FedeAdra25/despertadorInteligente/README.md

# Despetador Inteligente con STM32F103C8

### En este trabajo práctico desarrollaremos un sistema que todos hemos utilizado en algún momento, Se trata de un reloj despertador. Claramente, no se trata simplemente de un reloj despertador (ya que el sistema sería demasiado sencillo), sino que a su vez, cuenta con un display gráfico donde se muestra la hora, la fecha, la temperatura y la humedad actual. Además de todo esto, cuenta con la posibilidad de establecer una alarma a la hora deseada por el usuario.

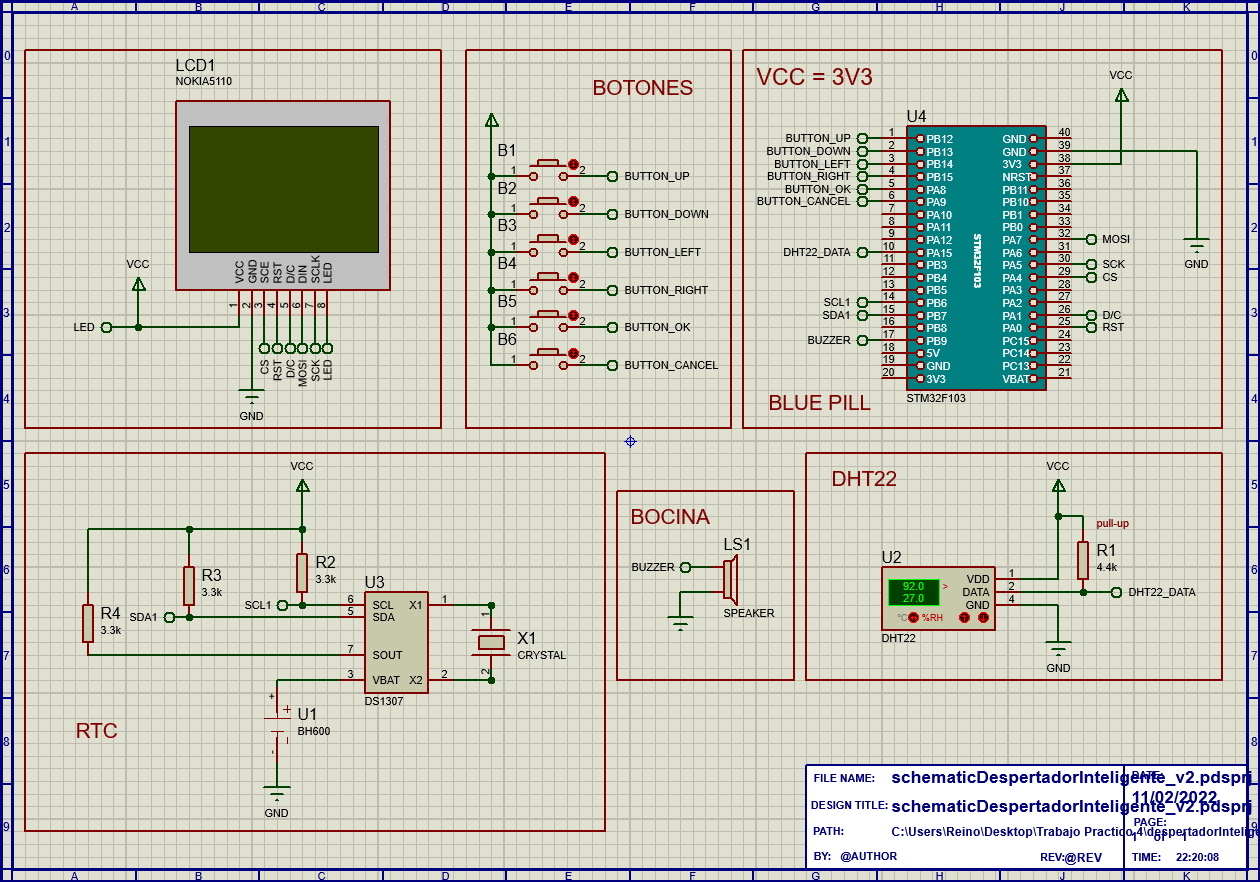
[picture p1: img/schematic.jpg]
Schematic

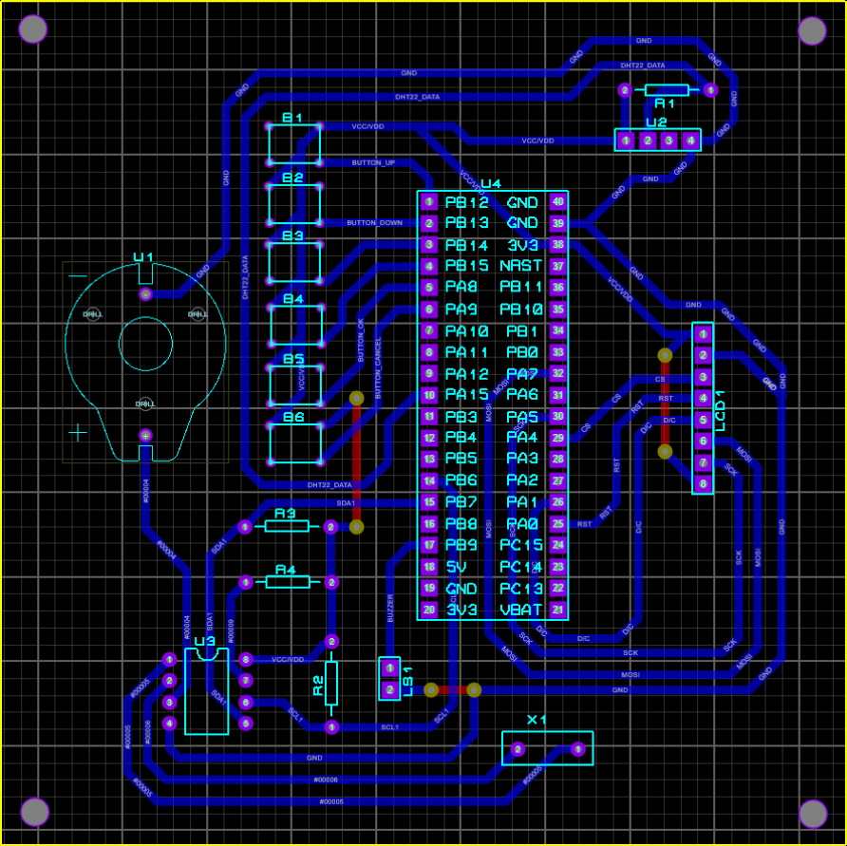
[picture p2: img/PCB_V2.jpg]
PCB

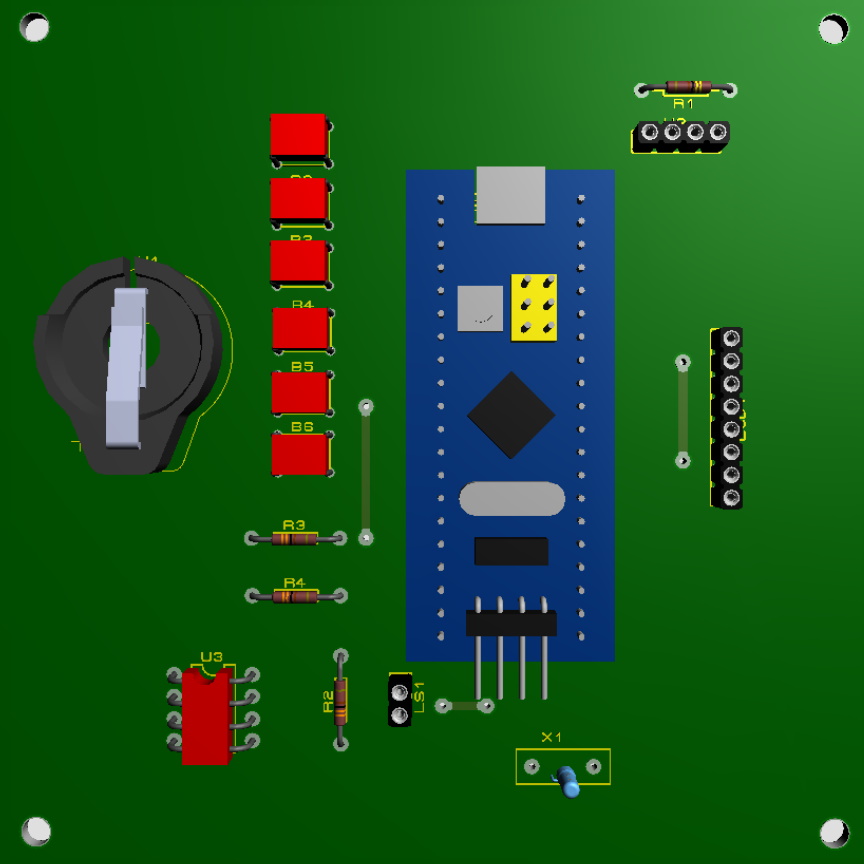
[picture p3: img/3D_MODEL.jpg]
3D Model
