FedeAdra25/despertadorInteligente/Archivos de uso Temporal/Auxiliares/README.md

python .\n5110_BMP_converter.py filename.bmp

el Archivo Filename.bmp debe ser creado en paint obligatoriamente
(Se intento usar Paint.net, descargar archivos .bmp o usar conversores online,
pero ninguno de estos funciona).

Luego de la conversion se genera un archivo .txt el cual contiene los datos
necesarios para utilizar la imagen en el STM32F1
