FedeAdra25/despertadorInteligente/Archivos de uso Temporal/MEF.drawio.png

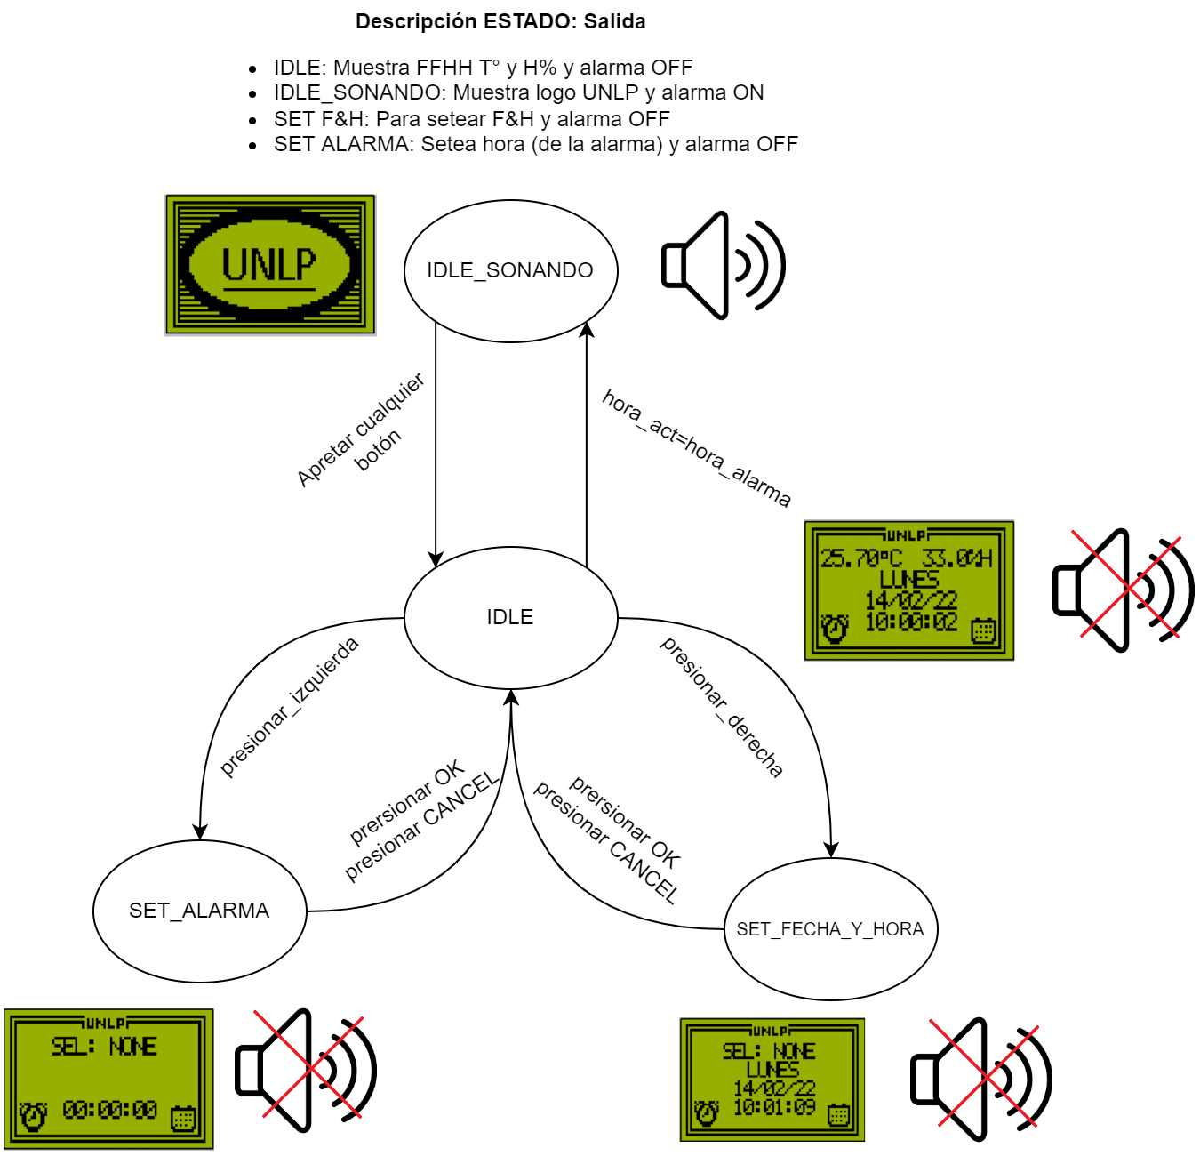
Archivos de uso Temporal/MEF.drawio.png
