FedeAdra25/despertadorInteligente/img/PCB_CUSTOM_CRYSTAL.jpg

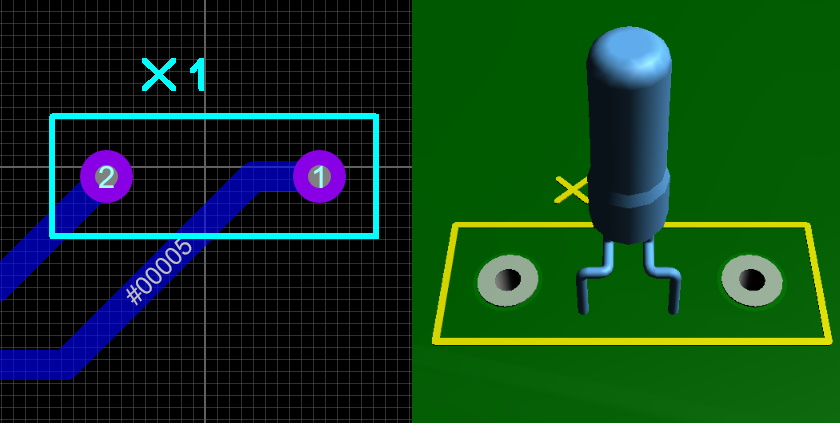
img/PCB_CUSTOM_CRYSTAL.jpg
