FedeAdra25/despertadorInteligente/img/PCB_PRINT.jpg

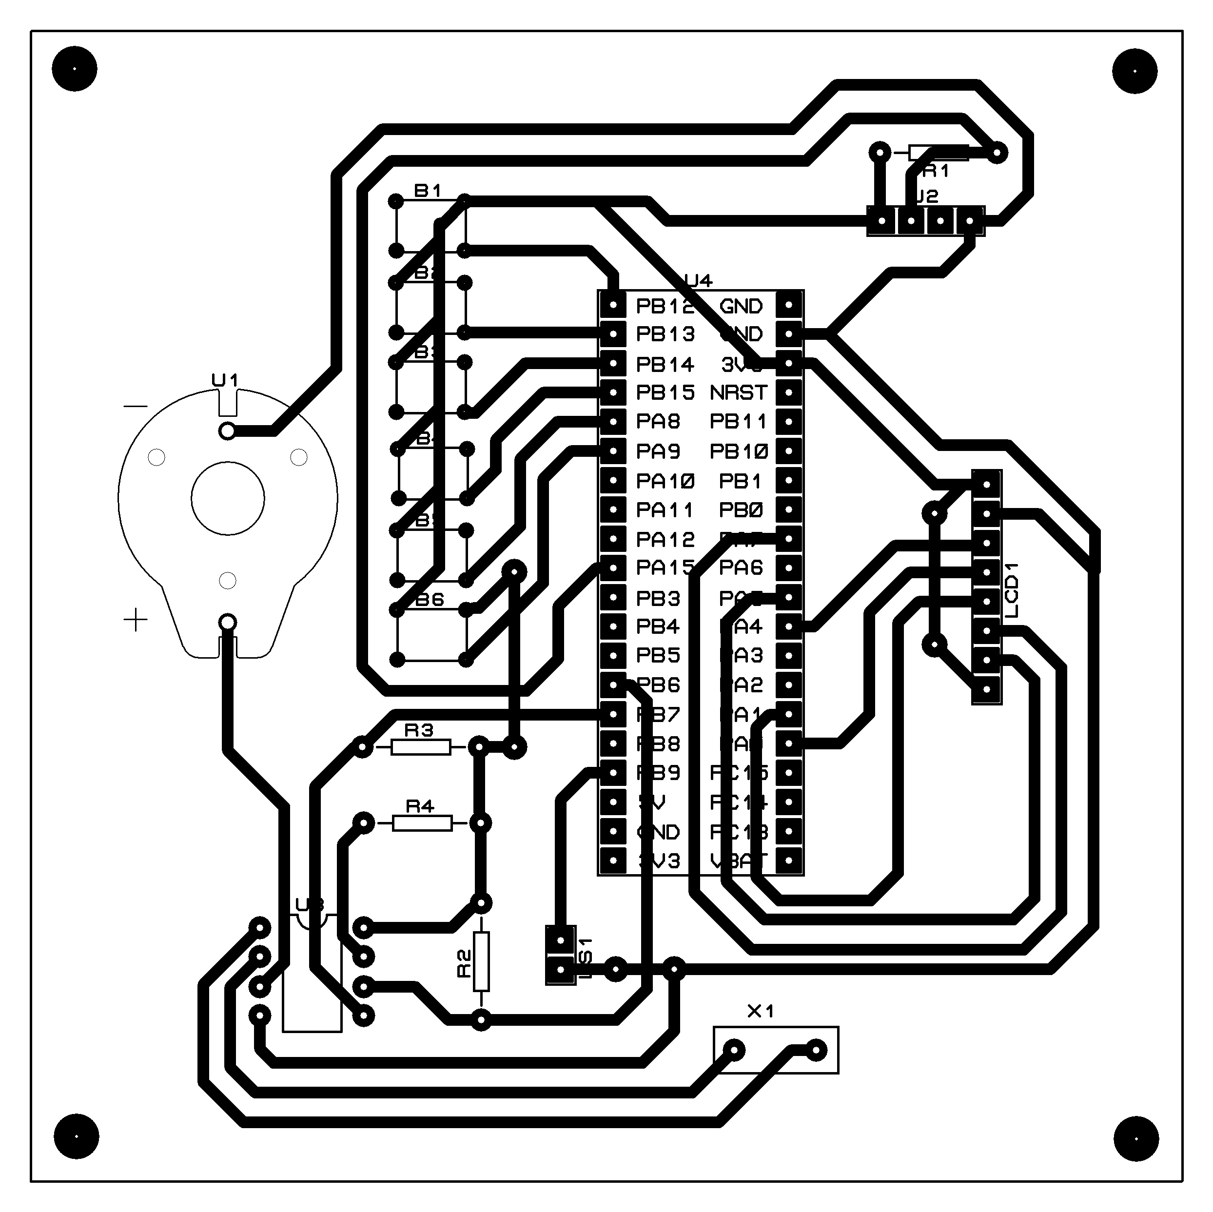
img/PCB_PRINT.jpg
