FedeAdra25/despertadorInteligente/img/PCB_PRINT_NO_COMPONENTS.jpg

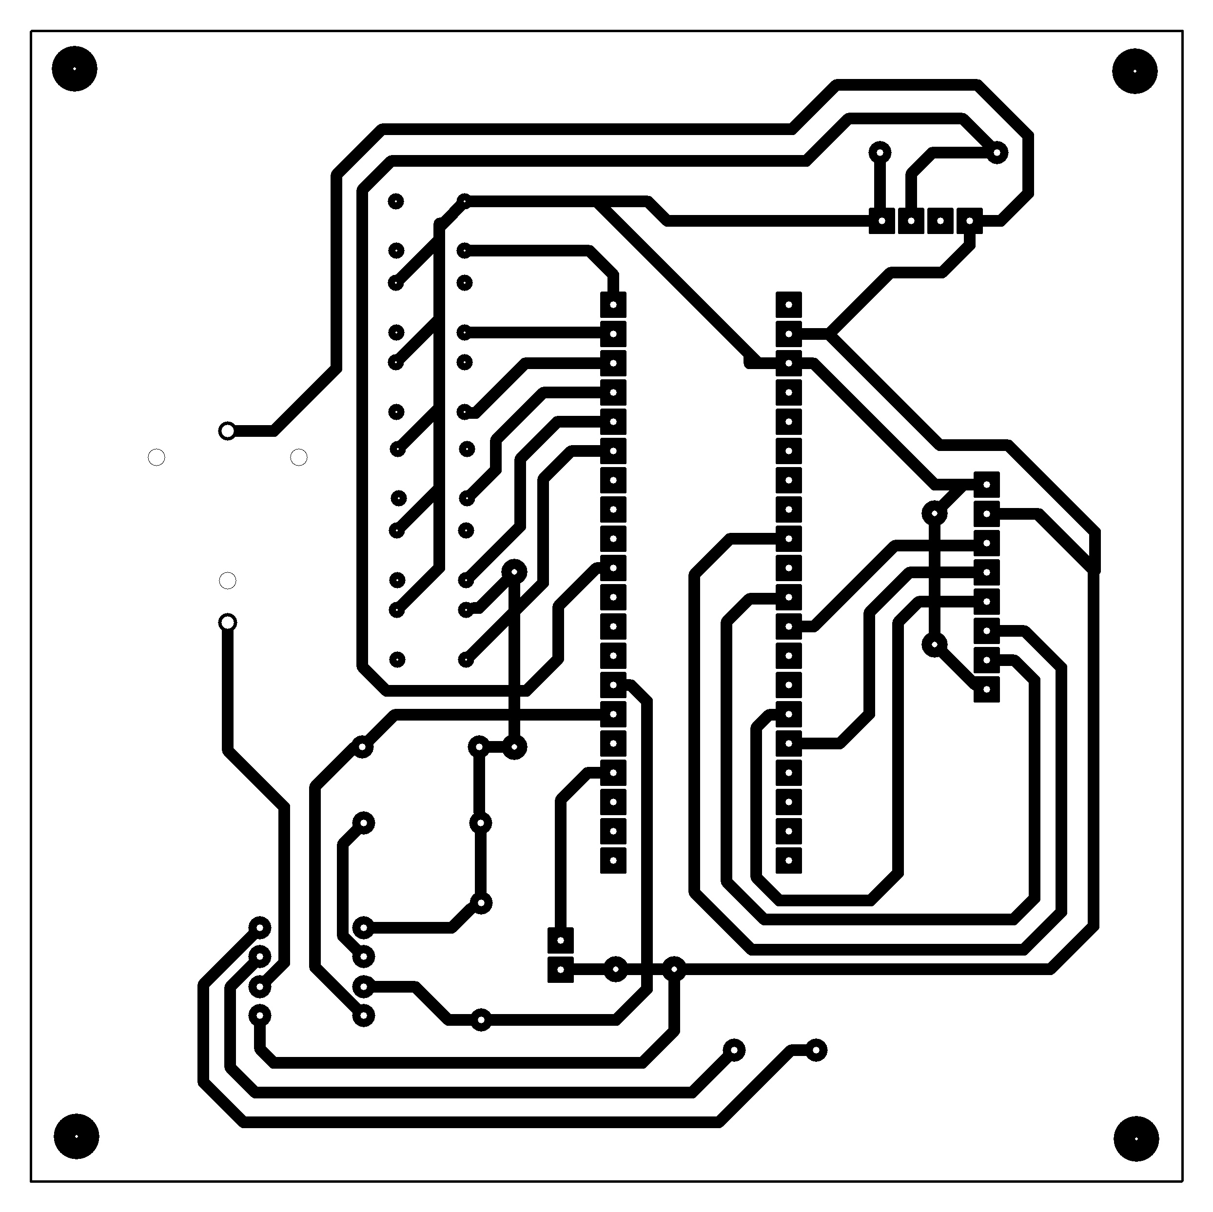
img/PCB_PRINT_NO_COMPONENTS.jpg
