FedeAdra25/despertadorInteligente/Archivos de uso Temporal/DHT22/TestingCubeMX_LED/MDK-ARM/TestingCubeMX_LED/TestingCubeMX_LED.htm

# Static Call Graph for image TestingCubeMX_LED\TestingCubeMX_LED.axf

#<CALLGRAPH># ARM Linker, 5060960: Last Updated: Tue Jan 18 18:20:20 2022

### Maximum Stack Usage = 324 bytes + Unknown(Functions without stacksize, Cycles, Untraceable Function Pointers)

### Call chain for Maximum Stack Depth:

_printf_f ⇒ _printf_fp_dec ⇒ _printf_fp_dec_real ⇒ _fp_digits ⇒ _btod_etento ⇒ _btod_emul ⇒ _e2e

### Functions with no stack information

- __user_initial_stackheap

### Mutually Recursive functions

- ADC1_2_IRQHandler ⇒ ADC1_2_IRQHandler
- BusFault_Handler ⇒ BusFault_Handler
- HardFault_Handler ⇒ HardFault_Handler
- MemManage_Handler ⇒ MemManage_Handler
- NMI_Handler ⇒ NMI_Handler
- UsageFault_Handler ⇒ UsageFault_Handler

### Function Pointers

- ADC1_2_IRQHandler from startup_stm32f103xb.o(.text) referenced from startup_stm32f103xb.o(RESET)
- BusFault_Handler from stm32f1xx_it.o(i.BusFault_Handler) referenced from startup_stm32f103xb.o(RESET)
- CAN1_RX1_IRQHandler from startup_stm32f103xb.o(.text) referenced from startup_stm32f103xb.o(RESET)
- CAN1_SCE_IRQHandler from startup_stm32f103xb.o(.text) referenced from startup_stm32f103xb.o(RESET)
- DMA1_Channel1_IRQHandler from startup_stm32f103xb.o(.text) referenced from startup_stm32f103xb.o(RESET)
- DMA1_Channel2_IRQHandler from startup_stm32f103xb.o(.text) referenced from startup_stm32f103xb.o(RESET)
- DMA1_Channel3_IRQHandler from startup_stm32f103xb.o(.text) referenced from startup_stm32f103xb.o(RESET)
- DMA1_Channel4_IRQHandler from startup_stm32f103xb.o(.text) referenced from startup_stm32f103xb.o(RESET)
- DMA1_Channel5_IRQHandler from startup_stm32f103xb.o(.text) referenced from startup_stm32f103xb.o(RESET)
- DMA1_Channel6_IRQHandler from startup_stm32f103xb.o(.text) referenced from startup_stm32f103xb.o(RESET)
- DMA1_Channel7_IRQHandler from startup_stm32f103xb.o(.text) referenced from startup_stm32f103xb.o(RESET)
- DebugMon_Handler from stm32f1xx_it.o(i.DebugMon_Handler) referenced from startup_stm32f103xb.o(RESET)
- EXTI0_IRQHandler from startup_stm32f103xb.o(.text) referenced from startup_stm32f103xb.o(RESET)
- EXTI15_10_IRQHandler from startup_stm32f103xb.o(.text) referenced from startup_stm32f103xb.o(RESET)
- EXTI1_IRQHandler from startup_stm32f103xb.o(.text) referenced from startup_stm32f103xb.o(RESET)
- EXTI2_IRQHandler from startup_stm32f103xb.o(.text) referenced from startup_stm32f103xb.o(RESET)
- EXTI3_IRQHandler from startup_stm32f103xb.o(.text) referenced from startup_stm32f103xb.o(RESET)
- EXTI4_IRQHandler from startup_stm32f103xb.o(.text) referenced from startup_stm32f103xb.o(RESET)
- EXTI9_5_IRQHandler from startup_stm32f103xb.o(.text) referenced from startup_stm32f103xb.o(RESET)
- FLASH_IRQHandler from startup_stm32f103xb.o(.text) referenced from startup_stm32f103xb.o(RESET)
- HardFault_Handler from stm32f1xx_it.o(i.HardFault_Handler) referenced from startup_stm32f103xb.o(RESET)
- I2C1_ER_IRQHandler from startup_stm32f103xb.o(.text) referenced from startup_stm32f103xb.o(RESET)
- I2C1_EV_IRQHandler from startup_stm32f103xb.o(.text) referenced from startup_stm32f103xb.o(RESET)
- I2C2_ER_IRQHandler from startup_stm32f103xb.o(.text) referenced from startup_stm32f103xb.o(RESET)
- I2C2_EV_IRQHandler from startup_stm32f103xb.o(.text) referenced from startup_stm32f103xb.o(RESET)
- MemManage_Handler from stm32f1xx_it.o(i.MemManage_Handler) referenced from startup_stm32f103xb.o(RESET)
- NMI_Handler from stm32f1xx_it.o(i.NMI_Handler) referenced from startup_stm32f103xb.o(RESET)
- PVD_IRQHandler from startup_stm32f103xb.o(.text) referenced from startup_stm32f103xb.o(RESET)
- PendSV_Handler from stm32f1xx_it.o(i.PendSV_Handler) referenced from startup_stm32f103xb.o(RESET)
- RCC_IRQHandler from startup_stm32f103xb.o(.text) referenced from startup_stm32f103xb.o(RESET)
- RTC_Alarm_IRQHandler from startup_stm32f103xb.o(.text) referenced from startup_stm32f103xb.o(RESET)
- RTC_IRQHandler from startup_stm32f103xb.o(.text) referenced from startup_stm32f103xb.o(RESET)
- Reset_Handler from startup_stm32f103xb.o(.text) referenced from startup_stm32f103xb.o(RESET)
- SPI1_IRQHandler from startup_stm32f103xb.o(.text) referenced from startup_stm32f103xb.o(RESET)
- SPI2_IRQHandler from startup_stm32f103xb.o(.text) referenced from startup_stm32f103xb.o(RESET)
- SVC_Handler from stm32f1xx_it.o(i.SVC_Handler) referenced from startup_stm32f103xb.o(RESET)
- SysTick_Handler from stm32f1xx_it.o(i.SysTick_Handler) referenced from startup_stm32f103xb.o(RESET)
- SystemInit from system_stm32f1xx.o(i.SystemInit) referenced from startup_stm32f103xb.o(.text)
- TAMPER_IRQHandler from startup_stm32f103xb.o(.text) referenced from startup_stm32f103xb.o(RESET)
- TIM1_BRK_IRQHandler from startup_stm32f103xb.o(.text) referenced from startup_stm32f103xb.o(RESET)
- TIM1_CC_IRQHandler from startup_stm32f103xb.o(.text) referenced from startup_stm32f103xb.o(RESET)
- TIM1_TRG_COM_IRQHandler from startup_stm32f103xb.o(.text) referenced from startup_stm32f103xb.o(RESET)
- TIM1_UP_IRQHandler from startup_stm32f103xb.o(.text) referenced from startup_stm32f103xb.o(RESET)
- TIM2_IRQHandler from startup_stm32f103xb.o(.text) referenced from startup_stm32f103xb.o(RESET)
- TIM3_IRQHandler from startup_stm32f103xb.o(.text) referenced from startup_stm32f103xb.o(RESET)
- TIM4_IRQHandler from startup_stm32f103xb.o(.text) referenced from startup_stm32f103xb.o(RESET)
- UART_DMAAbortOnError from stm32f1xx_hal_uart.o(i.UART_DMAAbortOnError) referenced from stm32f1xx_hal_uart.o(i.HAL_UART_IRQHandler)
- USART1_IRQHandler from stm32f1xx_it.o(i.USART1_IRQHandler) referenced from startup_stm32f103xb.o(RESET)
- USART2_IRQHandler from startup_stm32f103xb.o(.text) referenced from startup_stm32f103xb.o(RESET)
- USART3_IRQHandler from startup_stm32f103xb.o(.text) referenced from startup_stm32f103xb.o(RESET)
- USBWakeUp_IRQHandler from startup_stm32f103xb.o(.text) referenced from startup_stm32f103xb.o(RESET)
- USB_HP_CAN1_TX_IRQHandler from startup_stm32f103xb.o(.text) referenced from startup_stm32f103xb.o(RESET)
- USB_LP_CAN1_RX0_IRQHandler from startup_stm32f103xb.o(.text) referenced from startup_stm32f103xb.o(RESET)
- UsageFault_Handler from stm32f1xx_it.o(i.UsageFault_Handler) referenced from startup_stm32f103xb.o(RESET)
- WWDG_IRQHandler from startup_stm32f103xb.o(.text) referenced from startup_stm32f103xb.o(RESET)
- __main from __main.o(!!!main) referenced from startup_stm32f103xb.o(.text)
- _printf_input_char from _printf_char_common.o(.text) referenced from _printf_char_common.o(.text)
- _sputc from _sputc.o(.text) referenced from noretval__2sprintf.o(.text)

### Global Symbols

__main (Thumb, 8 bytes, Stack size 0 bytes, __main.o(!!!main))

[Calls]

- >> __scatterload
- >> __rt_entry

__scatterload (Thumb, 0 bytes, Stack size unknown bytes, __scatter.o(!!!scatter))

[Called By]

- >> __main

__scatterload_rt2 (Thumb, 44 bytes, Stack size unknown bytes, __scatter.o(!!!scatter), UNUSED)

[Calls]

- >> __rt_entry

__scatterload_rt2_thumb_only (Thumb, 0 bytes, Stack size unknown bytes, __scatter.o(!!!scatter), UNUSED)

__scatterload_null (Thumb, 0 bytes, Stack size unknown bytes, __scatter.o(!!!scatter), UNUSED)

__scatterload_copy (Thumb, 26 bytes, Stack size unknown bytes, __scatter_copy.o(!!handler_copy), UNUSED)

[Calls]

- >> __scatterload_copy

[Called By]

- >> __scatterload_copy

__scatterload_zeroinit (Thumb, 28 bytes, Stack size unknown bytes, __scatter_zi.o(!!handler_zi), UNUSED)

_printf_f (Thumb, 0 bytes, Stack size unknown bytes, _printf_f.o(.ARM.Collect$$_printf_percent$$00000003))

[Stack]

- Max Depth = 324 + Unknown Stack Size
- Call Chain = _printf_f ⇒ _printf_fp_dec ⇒ _printf_fp_dec_real ⇒ _fp_digits ⇒ _btod_etento ⇒ _btod_emul ⇒ _e2e

[Calls]

- >> _printf_fp_dec

_printf_percent (Thumb, 0 bytes, Stack size unknown bytes, _printf_percent.o(.ARM.Collect$$_printf_percent$$00000000))

[Called By]

- >> __printf

_printf_percent_end (Thumb, 0 bytes, Stack size unknown bytes, _printf_percent_end.o(.ARM.Collect$$_printf_percent$$00000017))

__rt_lib_init (Thumb, 0 bytes, Stack size unknown bytes, libinit.o(.ARM.Collect$$libinit$$00000000))

[Called By]

- >> __rt_entry_li

__rt_lib_init_fp_1 (Thumb, 0 bytes, Stack size unknown bytes, libinit2.o(.ARM.Collect$$libinit$$00000002))

__rt_lib_init_heap_1 (Thumb, 0 bytes, Stack size unknown bytes, libinit2.o(.ARM.Collect$$libinit$$0000000A))

__rt_lib_init_lc_common (Thumb, 0 bytes, Stack size unknown bytes, libinit2.o(.ARM.Collect$$libinit$$0000000F))

[Calls]

- >> __rt_locale

__rt_lib_init_preinit_1 (Thumb, 0 bytes, Stack size unknown bytes, libinit2.o(.ARM.Collect$$libinit$$00000004))

__rt_lib_init_rand_1 (Thumb, 0 bytes, Stack size unknown bytes, libinit2.o(.ARM.Collect$$libinit$$0000000E))

__rt_lib_init_user_alloc_1 (Thumb, 0 bytes, Stack size unknown bytes, libinit2.o(.ARM.Collect$$libinit$$0000000C))

__rt_lib_init_lc_collate_1 (Thumb, 0 bytes, Stack size unknown bytes, libinit2.o(.ARM.Collect$$libinit$$00000011))

__rt_lib_init_lc_ctype_1 (Thumb, 0 bytes, Stack size unknown bytes, libinit2.o(.ARM.Collect$$libinit$$00000013))

__rt_lib_init_lc_monetary_1 (Thumb, 0 bytes, Stack size unknown bytes, libinit2.o(.ARM.Collect$$libinit$$00000015))

__rt_lib_init_lc_numeric_2 (Thumb, 0 bytes, Stack size unknown bytes, libinit2.o(.ARM.Collect$$libinit$$00000016))

[Stack]

- Max Depth = 8 + Unknown Stack Size
- Call Chain = __rt_lib_init_lc_numeric_2 ⇒ _get_lc_numeric

[Calls]

- >> _get_lc_numeric

__rt_lib_init_alloca_1 (Thumb, 0 bytes, Stack size unknown bytes, libinit2.o(.ARM.Collect$$libinit$$0000002E))

__rt_lib_init_argv_1 (Thumb, 0 bytes, Stack size unknown bytes, libinit2.o(.ARM.Collect$$libinit$$0000002C))

__rt_lib_init_atexit_1 (Thumb, 0 bytes, Stack size unknown bytes, libinit2.o(.ARM.Collect$$libinit$$0000001B))

__rt_lib_init_clock_1 (Thumb, 0 bytes, Stack size unknown bytes, libinit2.o(.ARM.Collect$$libinit$$00000021))

__rt_lib_init_cpp_1 (Thumb, 0 bytes, Stack size unknown bytes, libinit2.o(.ARM.Collect$$libinit$$00000032))

__rt_lib_init_exceptions_1 (Thumb, 0 bytes, Stack size unknown bytes, libinit2.o(.ARM.Collect$$libinit$$00000030))

__rt_lib_init_fp_trap_1 (Thumb, 0 bytes, Stack size unknown bytes, libinit2.o(.ARM.Collect$$libinit$$0000001F))

__rt_lib_init_getenv_1 (Thumb, 0 bytes, Stack size unknown bytes, libinit2.o(.ARM.Collect$$libinit$$00000023))

__rt_lib_init_lc_numeric_1 (Thumb, 0 bytes, Stack size unknown bytes, libinit2.o(.ARM.Collect$$libinit$$00000017))

__rt_lib_init_lc_time_1 (Thumb, 0 bytes, Stack size unknown bytes, libinit2.o(.ARM.Collect$$libinit$$00000019))

__rt_lib_init_return (Thumb, 0 bytes, Stack size unknown bytes, libinit2.o(.ARM.Collect$$libinit$$00000033))

__rt_lib_init_signal_1 (Thumb, 0 bytes, Stack size unknown bytes, libinit2.o(.ARM.Collect$$libinit$$0000001D))

__rt_lib_init_stdio_1 (Thumb, 0 bytes, Stack size unknown bytes, libinit2.o(.ARM.Collect$$libinit$$00000025))

__rt_lib_shutdown (Thumb, 0 bytes, Stack size unknown bytes, libshutdown.o(.ARM.Collect$$libshutdown$$00000000))

[Called By]

- >> __rt_exit_ls

__rt_lib_shutdown_cpp_1 (Thumb, 0 bytes, Stack size unknown bytes, libshutdown2.o(.ARM.Collect$$libshutdown$$00000004))

__rt_lib_shutdown_fini_1 (Thumb, 0 bytes, Stack size unknown bytes, libshutdown2.o(.ARM.Collect$$libshutdown$$00000002))

__rt_lib_shutdown_fp_trap_1 (Thumb, 0 bytes, Stack size unknown bytes, libshutdown2.o(.ARM.Collect$$libshutdown$$00000009))

__rt_lib_shutdown_heap_1 (Thumb, 0 bytes, Stack size unknown bytes, libshutdown2.o(.ARM.Collect$$libshutdown$$00000011))

__rt_lib_shutdown_return (Thumb, 0 bytes, Stack size unknown bytes, libshutdown2.o(.ARM.Collect$$libshutdown$$00000012))

__rt_lib_shutdown_signal_1 (Thumb, 0 bytes, Stack size unknown bytes, libshutdown2.o(.ARM.Collect$$libshutdown$$0000000C))

__rt_lib_shutdown_stdio_1 (Thumb, 0 bytes, Stack size unknown bytes, libshutdown2.o(.ARM.Collect$$libshutdown$$00000006))

__rt_lib_shutdown_user_alloc_1 (Thumb, 0 bytes, Stack size unknown bytes, libshutdown2.o(.ARM.Collect$$libshutdown$$0000000E))

__rt_entry (Thumb, 0 bytes, Stack size unknown bytes, __rtentry.o(.ARM.Collect$$rtentry$$00000000))

[Called By]

- >> __scatterload_rt2
- >> __main

__rt_entry_presh_1 (Thumb, 0 bytes, Stack size unknown bytes, __rtentry2.o(.ARM.Collect$$rtentry$$00000002))

__rt_entry_sh (Thumb, 0 bytes, Stack size unknown bytes, __rtentry4.o(.ARM.Collect$$rtentry$$00000004))

[Stack]

- Max Depth = 8 + Unknown Stack Size
- Call Chain = __rt_entry_sh ⇒ __user_setup_stackheap

[Calls]

- >> __user_setup_stackheap

__rt_entry_li (Thumb, 0 bytes, Stack size unknown bytes, __rtentry2.o(.ARM.Collect$$rtentry$$0000000A))

[Calls]

- >> __rt_lib_init

__rt_entry_postsh_1 (Thumb, 0 bytes, Stack size unknown bytes, __rtentry2.o(.ARM.Collect$$rtentry$$00000009))

__rt_entry_main (Thumb, 0 bytes, Stack size unknown bytes, __rtentry2.o(.ARM.Collect$$rtentry$$0000000D))

[Stack]

- Max Depth = 216 + Unknown Stack Size
- Call Chain = __rt_entry_main ⇒ main ⇒ SystemClock_Config ⇒ HAL_RCC_ClockConfig ⇒ HAL_InitTick ⇒ HAL_NVIC_SetPriority

[Calls]

- >> main
- >> exit

__rt_entry_postli_1 (Thumb, 0 bytes, Stack size unknown bytes, __rtentry2.o(.ARM.Collect$$rtentry$$0000000C))

__rt_exit (Thumb, 0 bytes, Stack size unknown bytes, rtexit.o(.ARM.Collect$$rtexit$$00000000))

[Called By]

- >> exit

__rt_exit_ls (Thumb, 0 bytes, Stack size unknown bytes, rtexit2.o(.ARM.Collect$$rtexit$$00000003))

[Calls]

- >> __rt_lib_shutdown

__rt_exit_prels_1 (Thumb, 0 bytes, Stack size unknown bytes, rtexit2.o(.ARM.Collect$$rtexit$$00000002))

__rt_exit_exit (Thumb, 0 bytes, Stack size unknown bytes, rtexit2.o(.ARM.Collect$$rtexit$$00000004))

[Calls]

- >> _sys_exit

Reset_Handler (Thumb, 8 bytes, Stack size 0 bytes, startup_stm32f103xb.o(.text))
[Address Reference Count : 1]

- startup_stm32f103xb.o(RESET)

ADC1_2_IRQHandler (Thumb, 0 bytes, Stack size 0 bytes, startup_stm32f103xb.o(.text))

[Calls]

- >> ADC1_2_IRQHandler

[Called By]

- >> ADC1_2_IRQHandler

[Address Reference Count : 1]

- startup_stm32f103xb.o(RESET)

CAN1_RX1_IRQHandler (Thumb, 0 bytes, Stack size 0 bytes, startup_stm32f103xb.o(.text))
[Address Reference Count : 1]

- startup_stm32f103xb.o(RESET)

CAN1_SCE_IRQHandler (Thumb, 0 bytes, Stack size 0 bytes, startup_stm32f103xb.o(.text))
[Address Reference Count : 1]

- startup_stm32f103xb.o(RESET)

DMA1_Channel1_IRQHandler (Thumb, 0 bytes, Stack size 0 bytes, startup_stm32f103xb.o(.text))
[Address Reference Count : 1]

- startup_stm32f103xb.o(RESET)

DMA1_Channel2_IRQHandler (Thumb, 0 bytes, Stack size 0 bytes, startup_stm32f103xb.o(.text))
[Address Reference Count : 1]

- startup_stm32f103xb.o(RESET)

DMA1_Channel3_IRQHandler (Thumb, 0 bytes, Stack size 0 bytes, startup_stm32f103xb.o(.text))
[Address Reference Count : 1]

- startup_stm32f103xb.o(RESET)

DMA1_Channel4_IRQHandler (Thumb, 0 bytes, Stack size 0 bytes, startup_stm32f103xb.o(.text))
[Address Reference Count : 1]

- startup_stm32f103xb.o(RESET)

DMA1_Channel5_IRQHandler (Thumb, 0 bytes, Stack size 0 bytes, startup_stm32f103xb.o(.text))
[Address Reference Count : 1]

- startup_stm32f103xb.o(RESET)

DMA1_Channel6_IRQHandler (Thumb, 0 bytes, Stack size 0 bytes, startup_stm32f103xb.o(.text))
[Address Reference Count : 1]

- startup_stm32f103xb.o(RESET)

DMA1_Channel7_IRQHandler (Thumb, 0 bytes, Stack size 0 bytes, startup_stm32f103xb.o(.text))
[Address Reference Count : 1]

- startup_stm32f103xb.o(RESET)

EXTI0_IRQHandler (Thumb, 0 bytes, Stack size 0 bytes, startup_stm32f103xb.o(.text))
[Address Reference Count : 1]

- startup_stm32f103xb.o(RESET)

EXTI15_10_IRQHandler (Thumb, 0 bytes, Stack size 0 bytes, startup_stm32f103xb.o(.text))
[Address Reference Count : 1]

- startup_stm32f103xb.o(RESET)

EXTI1_IRQHandler (Thumb, 0 bytes, Stack size 0 bytes, startup_stm32f103xb.o(.text))
[Address Reference Count : 1]

- startup_stm32f103xb.o(RESET)

EXTI2_IRQHandler (Thumb, 0 bytes, Stack size 0 bytes, startup_stm32f103xb.o(.text))
[Address Reference Count : 1]

- startup_stm32f103xb.o(RESET)

EXTI3_IRQHandler (Thumb, 0 bytes, Stack size 0 bytes, startup_stm32f103xb.o(.text))
[Address Reference Count : 1]

- startup_stm32f103xb.o(RESET)

EXTI4_IRQHandler (Thumb, 0 bytes, Stack size 0 bytes, startup_stm32f103xb.o(.text))
[Address Reference Count : 1]

- startup_stm32f103xb.o(RESET)

EXTI9_5_IRQHandler (Thumb, 0 bytes, Stack size 0 bytes, startup_stm32f103xb.o(.text))
[Address Reference Count : 1]

- startup_stm32f103xb.o(RESET)

FLASH_IRQHandler (Thumb, 0 bytes, Stack size 0 bytes, startup_stm32f103xb.o(.text))
[Address Reference Count : 1]

- startup_stm32f103xb.o(RESET)

I2C1_ER_IRQHandler (Thumb, 0 bytes, Stack size 0 bytes, startup_stm32f103xb.o(.text))
[Address Reference Count : 1]

- startup_stm32f103xb.o(RESET)

I2C1_EV_IRQHandler (Thumb, 0 bytes, Stack size 0 bytes, startup_stm32f103xb.o(.text))
[Address Reference Count : 1]

- startup_stm32f103xb.o(RESET)

I2C2_ER_IRQHandler (Thumb, 0 bytes, Stack size 0 bytes, startup_stm32f103xb.o(.text))
[Address Reference Count : 1]

- startup_stm32f103xb.o(RESET)

I2C2_EV_IRQHandler (Thumb, 0 bytes, Stack size 0 bytes, startup_stm32f103xb.o(.text))
[Address Reference Count : 1]

- startup_stm32f103xb.o(RESET)

PVD_IRQHandler (Thumb, 0 bytes, Stack size 0 bytes, startup_stm32f103xb.o(.text))
[Address Reference Count : 1]

- startup_stm32f103xb.o(RESET)

RCC_IRQHandler (Thumb, 0 bytes, Stack size 0 bytes, startup_stm32f103xb.o(.text))
[Address Reference Count : 1]

- startup_stm32f103xb.o(RESET)

RTC_Alarm_IRQHandler (Thumb, 0 bytes, Stack size 0 bytes, startup_stm32f103xb.o(.text))
[Address Reference Count : 1]

- startup_stm32f103xb.o(RESET)

RTC_IRQHandler (Thumb, 0 bytes, Stack size 0 bytes, startup_stm32f103xb.o(.text))
[Address Reference Count : 1]

- startup_stm32f103xb.o(RESET)

SPI1_IRQHandler (Thumb, 0 bytes, Stack size 0 bytes, startup_stm32f103xb.o(.text))
[Address Reference Count : 1]

- startup_stm32f103xb.o(RESET)

SPI2_IRQHandler (Thumb, 0 bytes, Stack size 0 bytes, startup_stm32f103xb.o(.text))
[Address Reference Count : 1]

- startup_stm32f103xb.o(RESET)

TAMPER_IRQHandler (Thumb, 0 bytes, Stack size 0 bytes, startup_stm32f103xb.o(.text))
[Address Reference Count : 1]

- startup_stm32f103xb.o(RESET)

TIM1_BRK_IRQHandler (Thumb, 0 bytes, Stack size 0 bytes, startup_stm32f103xb.o(.text))
[Address Reference Count : 1]

- startup_stm32f103xb.o(RESET)

TIM1_CC_IRQHandler (Thumb, 0 bytes, Stack size 0 bytes, startup_stm32f103xb.o(.text))
[Address Reference Count : 1]

- startup_stm32f103xb.o(RESET)

TIM1_TRG_COM_IRQHandler (Thumb, 0 bytes, Stack size 0 bytes, startup_stm32f103xb.o(.text))
[Address Reference Count : 1]

- startup_stm32f103xb.o(RESET)

TIM1_UP_IRQHandler (Thumb, 0 bytes, Stack size 0 bytes, startup_stm32f103xb.o(.text))
[Address Reference Count : 1]

- startup_stm32f103xb.o(RESET)

TIM2_IRQHandler (Thumb, 0 bytes, Stack size 0 bytes, startup_stm32f103xb.o(.text))
[Address Reference Count : 1]

- startup_stm32f103xb.o(RESET)

TIM3_IRQHandler (Thumb, 0 bytes, Stack size 0 bytes, startup_stm32f103xb.o(.text))
[Address Reference Count : 1]

- startup_stm32f103xb.o(RESET)

TIM4_IRQHandler (Thumb, 0 bytes, Stack size 0 bytes, startup_stm32f103xb.o(.text))
[Address Reference Count : 1]

- startup_stm32f103xb.o(RESET)

USART2_IRQHandler (Thumb, 0 bytes, Stack size 0 bytes, startup_stm32f103xb.o(.text))
[Address Reference Count : 1]

- startup_stm32f103xb.o(RESET)

USART3_IRQHandler (Thumb, 0 bytes, Stack size 0 bytes, startup_stm32f103xb.o(.text))
[Address Reference Count : 1]

- startup_stm32f103xb.o(RESET)

USBWakeUp_IRQHandler (Thumb, 0 bytes, Stack size 0 bytes, startup_stm32f103xb.o(.text))
[Address Reference Count : 1]

- startup_stm32f103xb.o(RESET)

USB_HP_CAN1_TX_IRQHandler (Thumb, 0 bytes, Stack size 0 bytes, startup_stm32f103xb.o(.text))
[Address Reference Count : 1]

- startup_stm32f103xb.o(RESET)

USB_LP_CAN1_RX0_IRQHandler (Thumb, 0 bytes, Stack size 0 bytes, startup_stm32f103xb.o(.text))
[Address Reference Count : 1]

- startup_stm32f103xb.o(RESET)

WWDG_IRQHandler (Thumb, 0 bytes, Stack size 0 bytes, startup_stm32f103xb.o(.text))
[Address Reference Count : 1]

- startup_stm32f103xb.o(RESET)

__user_initial_stackheap (Thumb, 0 bytes, Stack size unknown bytes, startup_stm32f103xb.o(.text))

[Called By]

- >> __user_setup_stackheap

__2sprintf (Thumb, 34 bytes, Stack size 32 bytes, noretval__2sprintf.o(.text))

[Stack]

- Max Depth = 128 + Unknown Stack Size
- Call Chain = __2sprintf ⇒ _printf_char_common ⇒ __printf

[Calls]

- >> _sputc
- >> _printf_char_common

[Called By]

- >> main

__printf (Thumb, 270 bytes, Stack size 32 bytes, __printf_wp.o(.text))

[Stack]

- Max Depth = 32 + Unknown Stack Size
- Call Chain = __printf

[Calls]

- >> _printf_percent
- >> _is_digit

[Called By]

- >> _printf_char_common

strlen (Thumb, 62 bytes, Stack size 8 bytes, strlen.o(.text))

[Stack]

- Max Depth = 8
- Call Chain = strlen

[Called By]

- >> main

__aeabi_memclr4 (Thumb, 0 bytes, Stack size 4 bytes, rt_memclr_w.o(.text))

[Stack]

- Max Depth = 4
- Call Chain = __aeabi_memclr4

[Called By]

- >> SystemClock_Config

__aeabi_memclr8 (Thumb, 0 bytes, Stack size 4 bytes, rt_memclr_w.o(.text), UNUSED)

__rt_memclr_w (Thumb, 78 bytes, Stack size 4 bytes, rt_memclr_w.o(.text), UNUSED)

_memset_w (Thumb, 0 bytes, Stack size unknown bytes, rt_memclr_w.o(.text), UNUSED)

__use_two_region_memory (Thumb, 2 bytes, Stack size 0 bytes, heapauxi.o(.text), UNUSED)

__rt_heap_escrow$2region (Thumb, 2 bytes, Stack size 0 bytes, heapauxi.o(.text), UNUSED)

__rt_heap_expand$2region (Thumb, 2 bytes, Stack size 0 bytes, heapauxi.o(.text), UNUSED)

__lib_sel_fp_printf (Thumb, 2 bytes, Stack size 0 bytes, _printf_fp_dec.o(.text), UNUSED)

_printf_fp_dec_real (Thumb, 620 bytes, Stack size 104 bytes, _printf_fp_dec.o(.text))

[Stack]

- Max Depth = 324
- Call Chain = _printf_fp_dec_real ⇒ _fp_digits ⇒ _btod_etento ⇒ _btod_emul ⇒ _e2e

[Calls]

- >> __ARM_fpclassify
- >> _printf_fp_infnan
- >> __rt_locale
- >> _fp_digits

[Called By]

- >> _printf_fp_dec

_printf_char_common (Thumb, 32 bytes, Stack size 64 bytes, _printf_char_common.o(.text))

[Stack]

- Max Depth = 96 + Unknown Stack Size
- Call Chain = _printf_char_common ⇒ __printf

[Calls]

- >> __printf

[Called By]

- >> __2sprintf

_sputc (Thumb, 10 bytes, Stack size 0 bytes, _sputc.o(.text))

[Called By]

- >> __2sprintf

[Address Reference Count : 1]

- noretval__2sprintf.o(.text)

__rt_locale (Thumb, 8 bytes, Stack size 0 bytes, rt_locale_intlibspace.o(.text))

[Called By]

- >> __rt_lib_init_lc_common
- >> _printf_fp_dec_real

_ll_udiv10 (Thumb, 138 bytes, Stack size 12 bytes, lludiv10.o(.text))

[Stack]

- Max Depth = 12
- Call Chain = _ll_udiv10

[Called By]

- >> _fp_digits

_printf_fp_infnan (Thumb, 112 bytes, Stack size 24 bytes, _printf_fp_infnan.o(.text))

[Stack]

- Max Depth = 24
- Call Chain = _printf_fp_infnan

[Called By]

- >> _printf_fp_dec_real

_btod_etento (Thumb, 224 bytes, Stack size 72 bytes, bigflt0.o(.text))

[Stack]

- Max Depth = 124
- Call Chain = _btod_etento ⇒ _btod_emul ⇒ _e2e

[Calls]

- >> _btod_emul
- >> _btod_ediv

[Called By]

- >> _fp_digits

__user_libspace (Thumb, 8 bytes, Stack size 0 bytes, libspace.o(.text), UNUSED)

__user_perproc_libspace (Thumb, 0 bytes, Stack size 0 bytes, libspace.o(.text))

[Called By]

- >> __user_setup_stackheap

__user_perthread_libspace (Thumb, 0 bytes, Stack size 0 bytes, libspace.o(.text), UNUSED)

__user_setup_stackheap (Thumb, 74 bytes, Stack size 8 bytes, sys_stackheap_outer.o(.text))

[Stack]

- Max Depth = 8 + Unknown Stack Size
- Call Chain = __user_setup_stackheap

[Calls]

- >> __user_initial_stackheap
- >> __user_perproc_libspace

[Called By]

- >> __rt_entry_sh

exit (Thumb, 18 bytes, Stack size 8 bytes, exit.o(.text))

[Stack]

- Max Depth = 8 + Unknown Stack Size
- Call Chain = exit

[Calls]

- >> __rt_exit

[Called By]

- >> __rt_entry_main

strcmp (Thumb, 128 bytes, Stack size 0 bytes, strcmpv7m.o(.text))

[Called By]

- >> _get_lc_numeric

_sys_exit (Thumb, 8 bytes, Stack size 0 bytes, sys_exit.o(.text))

[Called By]

- >> __rt_exit_exit

__I$use$semihosting (Thumb, 0 bytes, Stack size 0 bytes, use_no_semi.o(.text), UNUSED)

__use_no_semihosting_swi (Thumb, 2 bytes, Stack size 0 bytes, use_no_semi.o(.text), UNUSED)

__semihosting_library_function (Thumb, 0 bytes, Stack size 0 bytes, indicate_semi.o(.text), UNUSED)

_btod_d2e (Thumb, 62 bytes, Stack size 0 bytes, btod.o(CL$$btod_d2e))

[Calls]

- >> _d2e_norm_op1

[Called By]

- >> _fp_digits

_d2e_denorm_low (Thumb, 70 bytes, Stack size 0 bytes, btod.o(CL$$btod_d2e_denorm_low))

[Called By]

- >> _d2e_norm_op1

_d2e_norm_op1 (Thumb, 96 bytes, Stack size 0 bytes, btod.o(CL$$btod_d2e_norm_op1))

[Calls]

- >> _d2e_denorm_low

[Called By]

- >> _btod_d2e

__btod_div_common (Thumb, 696 bytes, Stack size 24 bytes, btod.o(CL$$btod_div_common))

[Stack]

- Max Depth = 24
- Call Chain = __btod_div_common

[Called By]

- >> _btod_ediv

_e2e (Thumb, 220 bytes, Stack size 24 bytes, btod.o(CL$$btod_e2e))

[Stack]

- Max Depth = 24
- Call Chain = _e2e

[Called By]

- >> _btod_emul
- >> _btod_ediv

_btod_ediv (Thumb, 42 bytes, Stack size 28 bytes, btod.o(CL$$btod_ediv))

[Stack]

- Max Depth = 52
- Call Chain = _btod_ediv ⇒ _e2e

[Calls]

- >> _e2e
- >> __btod_div_common

[Called By]

- >> _btod_etento
- >> _fp_digits

_btod_emul (Thumb, 42 bytes, Stack size 28 bytes, btod.o(CL$$btod_emul))

[Stack]

- Max Depth = 52
- Call Chain = _btod_emul ⇒ _e2e

[Calls]

- >> __btod_mult_common
- >> _e2e

[Called By]

- >> _btod_etento
- >> _fp_digits

__btod_mult_common (Thumb, 580 bytes, Stack size 16 bytes, btod.o(CL$$btod_mult_common))

[Stack]

- Max Depth = 16
- Call Chain = __btod_mult_common

[Called By]

- >> _btod_emul

BusFault_Handler (Thumb, 2 bytes, Stack size 0 bytes, stm32f1xx_it.o(i.BusFault_Handler))

[Calls]

- >> BusFault_Handler

[Called By]

- >> BusFault_Handler

[Address Reference Count : 1]

- startup_stm32f103xb.o(RESET)

DHT22_GetTemp_Humidity (Thumb, 130 bytes, Stack size 32 bytes, my_dht22.o(i.DHT22_GetTemp_Humidity))

[Stack]

- Max Depth = 96
- Call Chain = DHT22_GetTemp_Humidity ⇒ ONE_WIRE_PinMode ⇒ HAL_GPIO_Init

[Calls]

- >> ONE_WIRE_Pin_Write
- >> ONE_WIRE_PinMode
- >> DelayMicroSeconds
- >> DHT22_ReadRaw
- >> __aeabi_ui2f
- >> __aeabi_fdiv

[Called By]

- >> main

DHT22_Init (Thumb, 34 bytes, Stack size 8 bytes, my_dht22.o(i.DHT22_Init))

[Stack]

- Max Depth = 8
- Call Chain = DHT22_Init

[Called By]

- >> main

DebugMon_Handler (Thumb, 2 bytes, Stack size 0 bytes, stm32f1xx_it.o(i.DebugMon_Handler))
[Address Reference Count : 1]

- startup_stm32f103xb.o(RESET)

HAL_DMA_Abort (Thumb, 70 bytes, Stack size 8 bytes, stm32f1xx_hal_dma.o(i.HAL_DMA_Abort))

[Stack]

- Max Depth = 8
- Call Chain = HAL_DMA_Abort

[Called By]

- >> HAL_UART_IRQHandler

HAL_DMA_Abort_IT (Thumb, 148 bytes, Stack size 8 bytes, stm32f1xx_hal_dma.o(i.HAL_DMA_Abort_IT))

[Stack]

- Max Depth = 8
- Call Chain = HAL_DMA_Abort_IT

[Called By]

- >> HAL_UART_IRQHandler

HAL_Delay (Thumb, 32 bytes, Stack size 16 bytes, stm32f1xx_hal.o(i.HAL_Delay))

[Stack]

- Max Depth = 16
- Call Chain = HAL_Delay

[Calls]

- >> HAL_GetTick

[Called By]

- >> main

HAL_GPIO_Init (Thumb, 446 bytes, Stack size 40 bytes, stm32f1xx_hal_gpio.o(i.HAL_GPIO_Init))

[Stack]

- Max Depth = 40
- Call Chain = HAL_GPIO_Init

[Called By]

- >> HAL_UART_MspInit
- >> MX_GPIO_Init
- >> ONE_WIRE_PinMode

HAL_GPIO_ReadPin (Thumb, 10 bytes, Stack size 0 bytes, stm32f1xx_hal_gpio.o(i.HAL_GPIO_ReadPin))

[Called By]

- >> ONE_WIRE_Pin_Read

HAL_GPIO_WritePin (Thumb, 10 bytes, Stack size 0 bytes, stm32f1xx_hal_gpio.o(i.HAL_GPIO_WritePin))

[Called By]

- >> main
- >> MX_GPIO_Init
- >> ONE_WIRE_Pin_Write

HAL_GetTick (Thumb, 6 bytes, Stack size 0 bytes, stm32f1xx_hal.o(i.HAL_GetTick))

[Called By]

- >> UART_WaitOnFlagUntilTimeout
- >> HAL_UART_Transmit
- >> HAL_RCC_OscConfig
- >> HAL_RCC_ClockConfig
- >> HAL_Delay

HAL_IncTick (Thumb, 12 bytes, Stack size 0 bytes, stm32f1xx_hal.o(i.HAL_IncTick))

[Called By]

- >> SysTick_Handler

HAL_Init (Thumb, 32 bytes, Stack size 8 bytes, stm32f1xx_hal.o(i.HAL_Init))

[Stack]

- Max Depth = 40
- Call Chain = HAL_Init ⇒ HAL_InitTick ⇒ HAL_NVIC_SetPriority

[Calls]

- >> HAL_MspInit
- >> HAL_InitTick
- >> HAL_NVIC_SetPriorityGrouping

[Called By]

- >> main

HAL_InitTick (Thumb, 54 bytes, Stack size 16 bytes, stm32f1xx_hal.o(i.HAL_InitTick))

[Stack]

- Max Depth = 32
- Call Chain = HAL_InitTick ⇒ HAL_NVIC_SetPriority

[Calls]

- >> HAL_NVIC_SetPriority
- >> HAL_SYSTICK_Config

[Called By]

- >> HAL_RCC_ClockConfig
- >> HAL_Init

HAL_MspInit (Thumb, 52 bytes, Stack size 8 bytes, stm32f1xx_hal_msp.o(i.HAL_MspInit))

[Stack]

- Max Depth = 8
- Call Chain = HAL_MspInit

[Called By]

- >> HAL_Init

HAL_NVIC_EnableIRQ (Thumb, 26 bytes, Stack size 0 bytes, stm32f1xx_hal_cortex.o(i.HAL_NVIC_EnableIRQ))

[Called By]

- >> HAL_UART_MspInit

HAL_NVIC_SetPriority (Thumb, 60 bytes, Stack size 16 bytes, stm32f1xx_hal_cortex.o(i.HAL_NVIC_SetPriority))

[Stack]

- Max Depth = 16
- Call Chain = HAL_NVIC_SetPriority

[Calls]

- >> __NVIC_SetPriority

[Called By]

- >> HAL_UART_MspInit
- >> HAL_InitTick

HAL_NVIC_SetPriorityGrouping (Thumb, 26 bytes, Stack size 0 bytes, stm32f1xx_hal_cortex.o(i.HAL_NVIC_SetPriorityGrouping))

[Called By]

- >> HAL_Init

HAL_RCC_ClockConfig (Thumb, 280 bytes, Stack size 32 bytes, stm32f1xx_hal_rcc.o(i.HAL_RCC_ClockConfig))

[Stack]

- Max Depth = 64
- Call Chain = HAL_RCC_ClockConfig ⇒ HAL_InitTick ⇒ HAL_NVIC_SetPriority

[Calls]

- >> HAL_RCC_GetSysClockFreq
- >> HAL_InitTick
- >> HAL_GetTick

[Called By]

- >> SystemClock_Config

HAL_RCC_GetPCLK1Freq (Thumb, 20 bytes, Stack size 0 bytes, stm32f1xx_hal_rcc.o(i.HAL_RCC_GetPCLK1Freq))

[Called By]

- >> UART_SetConfig

HAL_RCC_GetPCLK2Freq (Thumb, 20 bytes, Stack size 0 bytes, stm32f1xx_hal_rcc.o(i.HAL_RCC_GetPCLK2Freq))

[Called By]

- >> UART_SetConfig

HAL_RCC_GetSysClockFreq (Thumb, 74 bytes, Stack size 20 bytes, stm32f1xx_hal_rcc.o(i.HAL_RCC_GetSysClockFreq))

[Stack]

- Max Depth = 20
- Call Chain = HAL_RCC_GetSysClockFreq

[Called By]

- >> HAL_RCC_ClockConfig

HAL_RCC_OscConfig (Thumb, 778 bytes, Stack size 40 bytes, stm32f1xx_hal_rcc.o(i.HAL_RCC_OscConfig))

[Stack]

- Max Depth = 40
- Call Chain = HAL_RCC_OscConfig

[Calls]

- >> HAL_GetTick

[Called By]

- >> SystemClock_Config

HAL_SYSTICK_Config (Thumb, 40 bytes, Stack size 8 bytes, stm32f1xx_hal_cortex.o(i.HAL_SYSTICK_Config))

[Stack]

- Max Depth = 8
- Call Chain = HAL_SYSTICK_Config

[Calls]

- >> __NVIC_SetPriority

[Called By]

- >> HAL_InitTick

HAL_UARTEx_RxEventCallback (Thumb, 2 bytes, Stack size 0 bytes, stm32f1xx_hal_uart.o(i.HAL_UARTEx_RxEventCallback))

[Called By]

- >> UART_Receive_IT
- >> HAL_UART_IRQHandler

HAL_UART_ErrorCallback (Thumb, 2 bytes, Stack size 0 bytes, stm32f1xx_hal_uart.o(i.HAL_UART_ErrorCallback))

[Called By]

- >> UART_DMAAbortOnError
- >> HAL_UART_IRQHandler

HAL_UART_IRQHandler (Thumb, 520 bytes, Stack size 24 bytes, stm32f1xx_hal_uart.o(i.HAL_UART_IRQHandler))

[Stack]

- Max Depth = 32
- Call Chain = HAL_UART_IRQHandler ⇒ UART_Receive_IT

[Calls]

- >> UART_Receive_IT
- >> UART_EndRxTransfer
- >> HAL_UART_TxCpltCallback
- >> HAL_UART_ErrorCallback
- >> HAL_UARTEx_RxEventCallback
- >> HAL_DMA_Abort_IT
- >> HAL_DMA_Abort

[Called By]

- >> USART1_IRQHandler

HAL_UART_Init (Thumb, 98 bytes, Stack size 16 bytes, stm32f1xx_hal_uart.o(i.HAL_UART_Init))

[Stack]

- Max Depth = 88
- Call Chain = HAL_UART_Init ⇒ HAL_UART_MspInit ⇒ HAL_GPIO_Init

[Calls]

- >> UART_SetConfig
- >> HAL_UART_MspInit

[Called By]

- >> main

HAL_UART_MspInit (Thumb, 116 bytes, Stack size 32 bytes, stm32f1xx_hal_msp.o(i.HAL_UART_MspInit))

[Stack]

- Max Depth = 72
- Call Chain = HAL_UART_MspInit ⇒ HAL_GPIO_Init

[Calls]

- >> HAL_NVIC_SetPriority
- >> HAL_NVIC_EnableIRQ
- >> HAL_GPIO_Init

[Called By]

- >> HAL_UART_Init

HAL_UART_RxCpltCallback (Thumb, 2 bytes, Stack size 0 bytes, stm32f1xx_hal_uart.o(i.HAL_UART_RxCpltCallback))

[Called By]

- >> UART_Receive_IT

HAL_UART_Transmit (Thumb, 178 bytes, Stack size 32 bytes, stm32f1xx_hal_uart.o(i.HAL_UART_Transmit))

[Stack]

- Max Depth = 56
- Call Chain = HAL_UART_Transmit ⇒ UART_WaitOnFlagUntilTimeout

[Calls]

- >> UART_WaitOnFlagUntilTimeout
- >> HAL_GetTick

[Called By]

- >> main

HAL_UART_TxCpltCallback (Thumb, 2 bytes, Stack size 0 bytes, stm32f1xx_hal_uart.o(i.HAL_UART_TxCpltCallback))

[Called By]

- >> HAL_UART_IRQHandler

HardFault_Handler (Thumb, 2 bytes, Stack size 0 bytes, stm32f1xx_it.o(i.HardFault_Handler))

[Calls]

- >> HardFault_Handler

[Called By]

- >> HardFault_Handler

[Address Reference Count : 1]

- startup_stm32f103xb.o(RESET)

MemManage_Handler (Thumb, 2 bytes, Stack size 0 bytes, stm32f1xx_it.o(i.MemManage_Handler))

[Calls]

- >> MemManage_Handler

[Called By]

- >> MemManage_Handler

[Address Reference Count : 1]

- startup_stm32f103xb.o(RESET)

NMI_Handler (Thumb, 2 bytes, Stack size 0 bytes, stm32f1xx_it.o(i.NMI_Handler))

[Calls]

- >> NMI_Handler

[Called By]

- >> NMI_Handler

[Address Reference Count : 1]

- startup_stm32f103xb.o(RESET)

PendSV_Handler (Thumb, 2 bytes, Stack size 0 bytes, stm32f1xx_it.o(i.PendSV_Handler))
[Address Reference Count : 1]

- startup_stm32f103xb.o(RESET)

SVC_Handler (Thumb, 2 bytes, Stack size 0 bytes, stm32f1xx_it.o(i.SVC_Handler))
[Address Reference Count : 1]

- startup_stm32f103xb.o(RESET)

SysTick_Handler (Thumb, 4 bytes, Stack size 0 bytes, stm32f1xx_it.o(i.SysTick_Handler))

[Calls]

- >> HAL_IncTick

[Address Reference Count : 1]

- startup_stm32f103xb.o(RESET)

SystemClock_Config (Thumb, 80 bytes, Stack size 72 bytes, main.o(i.SystemClock_Config))

[Stack]

- Max Depth = 136
- Call Chain = SystemClock_Config ⇒ HAL_RCC_ClockConfig ⇒ HAL_InitTick ⇒ HAL_NVIC_SetPriority

[Calls]

- >> HAL_RCC_OscConfig
- >> HAL_RCC_ClockConfig
- >> __aeabi_memclr4

[Called By]

- >> main

SystemInit (Thumb, 2 bytes, Stack size 0 bytes, system_stm32f1xx.o(i.SystemInit))
[Address Reference Count : 1]

- startup_stm32f103xb.o(.text)

USART1_IRQHandler (Thumb, 6 bytes, Stack size 0 bytes, stm32f1xx_it.o(i.USART1_IRQHandler))

[Stack]

- Max Depth = 32
- Call Chain = USART1_IRQHandler ⇒ HAL_UART_IRQHandler ⇒ UART_Receive_IT

[Calls]

- >> HAL_UART_IRQHandler

[Address Reference Count : 1]

- startup_stm32f103xb.o(RESET)

UsageFault_Handler (Thumb, 2 bytes, Stack size 0 bytes, stm32f1xx_it.o(i.UsageFault_Handler))

[Calls]

- >> UsageFault_Handler

[Called By]

- >> UsageFault_Handler

[Address Reference Count : 1]

- startup_stm32f103xb.o(RESET)

__ARM_fpclassify (Thumb, 40 bytes, Stack size 0 bytes, fpclassify.o(i.__ARM_fpclassify))

[Called By]

- >> _printf_fp_dec_real

_is_digit (Thumb, 14 bytes, Stack size 0 bytes, __printf_wp.o(i._is_digit))

[Called By]

- >> __printf

main (Thumb, 334 bytes, Stack size 80 bytes, main.o(i.main))

[Stack]

- Max Depth = 216 + Unknown Stack Size
- Call Chain = main ⇒ SystemClock_Config ⇒ HAL_RCC_ClockConfig ⇒ HAL_InitTick ⇒ HAL_NVIC_SetPriority

[Calls]

- >> HAL_UART_Transmit
- >> HAL_UART_Init
- >> HAL_Init
- >> HAL_Delay
- >> SystemClock_Config
- >> MX_GPIO_Init
- >> HAL_GPIO_WritePin
- >> DHT22_Init
- >> DHT22_GetTemp_Humidity
- >> __aeabi_f2d
- >> strlen
- >> __2sprintf

[Called By]

- >> __rt_entry_main

_get_lc_numeric (Thumb, 44 bytes, Stack size 8 bytes, lc_numeric_c.o(locale$$code))

[Stack]

- Max Depth = 8
- Call Chain = _get_lc_numeric

[Calls]

- >> strcmp

[Called By]

- >> __rt_lib_init_lc_numeric_2

__fpl_dretinf (Thumb, 12 bytes, Stack size 0 bytes, dretinf.o(x$fpl$dretinf), UNUSED)

[Called By]

- >> _f2d

__aeabi_f2d (Thumb, 0 bytes, Stack size 16 bytes, f2d.o(x$fpl$f2d))

[Stack]

- Max Depth = 16
- Call Chain = __aeabi_f2d

[Called By]

- >> main

_f2d (Thumb, 86 bytes, Stack size 16 bytes, f2d.o(x$fpl$f2d), UNUSED)

[Calls]

- >> __fpl_fnaninf
- >> __fpl_dretinf

__aeabi_fdiv (Thumb, 0 bytes, Stack size 16 bytes, fdiv.o(x$fpl$fdiv))

[Stack]

- Max Depth = 16
- Call Chain = __aeabi_fdiv

[Called By]

- >> DHT22_GetTemp_Humidity

_fdiv (Thumb, 384 bytes, Stack size 16 bytes, fdiv.o(x$fpl$fdiv), UNUSED)

[Calls]

- >> __fpl_fretinf
- >> __fpl_fnaninf

__aeabi_ui2f (Thumb, 0 bytes, Stack size 0 bytes, fflt_clz.o(x$fpl$ffltu))

[Called By]

- >> DHT22_GetTemp_Humidity

_ffltu (Thumb, 38 bytes, Stack size 0 bytes, fflt_clz.o(x$fpl$ffltu), UNUSED)

__fpl_fnaninf (Thumb, 140 bytes, Stack size 8 bytes, fnaninf.o(x$fpl$fnaninf), UNUSED)

[Called By]

- >> _fdiv
- >> _f2d

__fpl_fretinf (Thumb, 10 bytes, Stack size 0 bytes, fretinf.o(x$fpl$fretinf), UNUSED)

[Called By]

- >> _fdiv

_printf_fp_dec (Thumb, 4 bytes, Stack size 0 bytes, printf1.o(x$fpl$printf1))

[Stack]

- Max Depth = 324
- Call Chain = _printf_fp_dec ⇒ _printf_fp_dec_real ⇒ _fp_digits ⇒ _btod_etento ⇒ _btod_emul ⇒ _e2e

[Calls]

- >> _printf_fp_dec_real

[Called By]

- >> _printf_f

### Local Symbols

DHT22_ReadRaw (Thumb, 148 bytes, Stack size 24 bytes, my_dht22.o(i.DHT22_ReadRaw))

[Stack]

- Max Depth = 32
- Call Chain = DHT22_ReadRaw ⇒ ONE_WIRE_Pin_Read

[Calls]

- >> ONE_WIRE_Pin_Read
- >> DelayMicroSeconds

[Called By]

- >> DHT22_GetTemp_Humidity

DelayMicroSeconds (Thumb, 18 bytes, Stack size 0 bytes, my_dht22.o(i.DelayMicroSeconds))

[Called By]

- >> DHT22_GetTemp_Humidity
- >> DHT22_ReadRaw

ONE_WIRE_PinMode (Thumb, 42 bytes, Stack size 24 bytes, my_dht22.o(i.ONE_WIRE_PinMode))

[Stack]

- Max Depth = 64
- Call Chain = ONE_WIRE_PinMode ⇒ HAL_GPIO_Init

[Calls]

- >> HAL_GPIO_Init

[Called By]

- >> DHT22_GetTemp_Humidity

ONE_WIRE_Pin_Read (Thumb, 18 bytes, Stack size 8 bytes, my_dht22.o(i.ONE_WIRE_Pin_Read))

[Stack]

- Max Depth = 8
- Call Chain = ONE_WIRE_Pin_Read

[Calls]

- >> HAL_GPIO_ReadPin

[Called By]

- >> DHT22_ReadRaw

ONE_WIRE_Pin_Write (Thumb, 16 bytes, Stack size 0 bytes, my_dht22.o(i.ONE_WIRE_Pin_Write))

[Calls]

- >> HAL_GPIO_WritePin

[Called By]

- >> DHT22_GetTemp_Humidity

MX_GPIO_Init (Thumb, 176 bytes, Stack size 56 bytes, main.o(i.MX_GPIO_Init))

[Stack]

- Max Depth = 96
- Call Chain = MX_GPIO_Init ⇒ HAL_GPIO_Init

[Calls]

- >> HAL_GPIO_WritePin
- >> HAL_GPIO_Init

[Called By]

- >> main

UART_DMAAbortOnError (Thumb, 16 bytes, Stack size 8 bytes, stm32f1xx_hal_uart.o(i.UART_DMAAbortOnError))

[Stack]

- Max Depth = 8
- Call Chain = UART_DMAAbortOnError

[Calls]

- >> HAL_UART_ErrorCallback

[Address Reference Count : 1]

- stm32f1xx_hal_uart.o(i.HAL_UART_IRQHandler)

UART_EndRxTransfer (Thumb, 48 bytes, Stack size 0 bytes, stm32f1xx_hal_uart.o(i.UART_EndRxTransfer))

[Called By]

- >> HAL_UART_IRQHandler

UART_Receive_IT (Thumb, 182 bytes, Stack size 8 bytes, stm32f1xx_hal_uart.o(i.UART_Receive_IT))

[Stack]

- Max Depth = 8
- Call Chain = UART_Receive_IT

[Calls]

- >> HAL_UART_RxCpltCallback
- >> HAL_UARTEx_RxEventCallback

[Called By]

- >> HAL_UART_IRQHandler

UART_SetConfig (Thumb, 178 bytes, Stack size 16 bytes, stm32f1xx_hal_uart.o(i.UART_SetConfig))

[Stack]

- Max Depth = 16
- Call Chain = UART_SetConfig

[Calls]

- >> HAL_RCC_GetPCLK2Freq
- >> HAL_RCC_GetPCLK1Freq

[Called By]

- >> HAL_UART_Init

UART_WaitOnFlagUntilTimeout (Thumb, 100 bytes, Stack size 24 bytes, stm32f1xx_hal_uart.o(i.UART_WaitOnFlagUntilTimeout))

[Stack]

- Max Depth = 24
- Call Chain = UART_WaitOnFlagUntilTimeout

[Calls]

- >> HAL_GetTick

[Called By]

- >> HAL_UART_Transmit

__NVIC_SetPriority (Thumb, 32 bytes, Stack size 0 bytes, stm32f1xx_hal_cortex.o(i.__NVIC_SetPriority))

[Called By]

- >> HAL_NVIC_SetPriority
- >> HAL_SYSTICK_Config

_fp_digits (Thumb, 432 bytes, Stack size 96 bytes, _printf_fp_dec.o(.text))

[Stack]

- Max Depth = 220
- Call Chain = _fp_digits ⇒ _btod_etento ⇒ _btod_emul ⇒ _e2e

[Calls]

- >> _btod_emul
- >> _btod_ediv
- >> _btod_d2e
- >> _btod_etento
- >> _ll_udiv10

[Called By]

- >> _printf_fp_dec_real

_printf_input_char (Thumb, 10 bytes, Stack size 0 bytes, _printf_char_common.o(.text))
[Address Reference Count : 1]

- _printf_char_common.o(.text)

### Undefined Global Symbols
