FedeAdra25/despertadorInteligente/(list of files, drawings)

Other design files:
Archivos de uso Temporal/DHT22 with Display/LED + DHT11 with CubeMX.pdsprj
Archivos de uso Temporal/DHT22/LED + DHT11 with CubeMX.pdsprj
Archivos de uso Temporal/DHT22_Fede/LED + DHT11.pdsprj
Archivos de uso Temporal/DISPLAY_SPI_Fede/SPI Display.pdsprj
Archivos de uso Temporal/RTC/rtc.pdsprj
Archivos de uso Temporal/SPI + DISPLAY/SPI Display.pdsprj
Archivos de uso Temporal/UART Proteus/UART + DHT22.pdsprj
Firmware/Despertador_Inteligente.pdsprj
Schematic/schematicDespertadorInteligente_v2.pdsprj
