FedeAdra25/despertadorInteligente/Archivos de uso Temporal/SPI + DISPLAY/STM32F103C6/n5110_drive.h

#ifndef N5510_DRIVE_H
#define N5510_DRIVE_H



/*MACROS (change for port)*/
#define DISPLAY_PORT GPIOA
#define DISPLAY_PORT_DR GPIOA->ODR
#define DISPLAY_PORT_CONFIG GPIOA->CRL




/* Function Headers */

void n5110_init(unsigned short spi);
void n5110_print(short x, short y, char str[],unsigned short spi);
void n5110_pos(short x, short y);


/* Estructura para las imagenes */
typedef struct State {
	
	/* Height and Weight*/
	unsigned short h;
	unsigned short w;
	
	/* Coordenadas X e Y */
	unsigned short x;	
	unsigned short y;
	
	//Pueden ser los que quieras, puse 20 por poner
	const unsigned char *image[20];	
	
} ImgType;

void n5110_print_buffer(unsigned char screen_buffer[][84]);
void n5110_clear_buffer(unsigned char screen_buffer[][84]);
void n5110_clear(void);

void n5110_update_buffer(ImgType img, unsigned short img_number, unsigned char screen_buffer[][84]);
void n5110_update_str_buffer(short y, short x,char str[], unsigned char screen_buffer[][84]);

/* https://playground.arduino.cc/Code/PCD8544/ 
Changed byte to Char for C code.
*/
static const char ASCII[][5] =
{
 {0x00, 0x00, 0x00, 0x00, 0x00} // 20  
,{0x00, 0x00, 0x5f, 0x00, 0x00} // 21 !
,{0x00, 0x07, 0x00, 0x07, 0x00} // 22 "
,{0x14, 0x7f, 0x14, 0x7f, 0x14} // 23 #
,{0x24, 0x2a, 0x7f, 0x2a, 0x12} // 24 $
,{0x23, 0x13, 0x08, 0x64, 0x62} // 25 %
,{0x36, 0x49, 0x55, 0x22, 0x50} // 26 &
,{0x00, 0x05, 0x03, 0x00, 0x00} // 27 '
,{0x00, 0x1c, 0x22, 0x41, 0x00} // 28 (
,{0x00, 0x41, 0x22, 0x1c, 0x00} // 29 )
,{0x14, 0x08, 0x3e, 0x08, 0x14} // 2a *
,{0x08, 0x08, 0x3e, 0x08, 0x08} // 2b +
,{0x00, 0x50, 0x30, 0x00, 0x00} // 2c ,
,{0x08, 0x08, 0x08, 0x08, 0x08} // 2d -
,{0x00, 0x60, 0x60, 0x00, 0x00} // 2e .
,{0x20, 0x10, 0x08, 0x04, 0x02} // 2f /
,{0x3e, 0x51, 0x49, 0x45, 0x3e} // 30 0
,{0x00, 0x42, 0x7f, 0x40, 0x00} // 31 1
,{0x42, 0x61, 0x51, 0x49, 0x46} // 32 2
,{0x21, 0x41, 0x45, 0x4b, 0x31} // 33 3
,{0x18, 0x14, 0x12, 0x7f, 0x10} // 34 4
,{0x27, 0x45, 0x45, 0x45, 0x39} // 35 5
,{0x3c, 0x4a, 0x49, 0x49, 0x30} // 36 6
,{0x01, 0x71, 0x09, 0x05, 0x03} // 37 7
,{0x36, 0x49, 0x49, 0x49, 0x36} // 38 8
,{0x06, 0x49, 0x49, 0x29, 0x1e} // 39 9
,{0x00, 0x36, 0x36, 0x00, 0x00} // 3a :
,{0x00, 0x56, 0x36, 0x00, 0x00} // 3b ;
,{0x08, 0x14, 0x22, 0x41, 0x00} // 3c <
,{0x14, 0x14, 0x14, 0x14, 0x14} // 3d =
,{0x00, 0x41, 0x22, 0x14, 0x08} // 3e >
,{0x02, 0x01, 0x51, 0x09, 0x06} // 3f ?
,{0x32, 0x49, 0x79, 0x41, 0x3e} // 40 @
,{0x7e, 0x11, 0x11, 0x11, 0x7e} // 41 A
,{0x7f, 0x49, 0x49, 0x49, 0x36} // 42 B
,{0x3e, 0x41, 0x41, 0x41, 0x22} // 43 C
,{0x7f, 0x41, 0x41, 0x22, 0x1c} // 44 D
,{0x7f, 0x49, 0x49, 0x49, 0x41} // 45 E
,{0x7f, 0x09, 0x09, 0x09, 0x01} // 46 F
,{0x3e, 0x41, 0x49, 0x49, 0x7a} // 47 G
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
};

/* IMAGE TYPE DECLARATIONS.
THIS DATA IS PROVIDED BY A PYTHON SCRYPT*/


/* IMAGE DATA provided by a python Script*/

/* WELCOME SCREEN UNLP */
static unsigned short welcome_screen_rows = 6;
static unsigned short welcome_screen_cols = 84;
static unsigned char welcome_screen[] = 
{
0xff,0x1,0xfd,0x55,0x55,0x55,0x55,0x55,0x55,0x55,0x55,0x55,0x55,0x55,0x55,0x55,0xd5,0xd5,0xd5,0xd5,0xf5,0xf5,0xf5,0xf5,0xf5,0xf5,0xf5,0xf5,0xfd,0xfd,0xfd,0xfd,0xfd,0xfd,0x7d,0x7d,0x7d,0x7d,0x7d,0x7d,0x7d,0x7d,0x7d,0x7d,0x7d,0x7d,0x7d,0x7d,0x7d,0x7d,0xfd,0xfd,0xfd,0xfd,0xfd,0xfd,0xf5,0xf5,0xf5,0xf5,0xf5,0xf5,0xf5,0xf5,0xd5,0xd5,0xd5,0xd5,0x55,0x55,0x55,0x55,0x55,0x55,0x55,0x55,0x55,0x55,0x55,0x55,0x55,0xfd,0x1,0xff,
0xff,0x0,0xff,0x55,0x55,0xd5,0xd5,0xf5,0xf5,0xfd,0xfd,0xfd,0x7f,0x7f,0x3f,0x1f,0x1f,0xf,0xf,0x7,0x7,0x3,0x3,0x3,0x1,0x1,0x1,0x1,0x0,0x0,0x0,0x0,0x0,0x0,0x0,0x0,0x0,0x0,0x0,0x0,0x0,0x0,0x0,0x0,0x0,0x0,0x0,0x0,0x0,0x0,0x0,0x0,0x0,0x0,0x0,0x0,0x1,0x1,0x1,0x1,0x3,0x3,0x3,0x7,0x7,0xf,0xf,0x1f,0x1f,0x3f,0x3f,0x7f,0xfd,0xfd,0xfd,0xf5,0xf5,0xd5,0xd5,0x55,0x55,0xff,0x0,0xff,
0xff,0x0,0xff,0xfd,0xff,0xff,0xff,0x1f,0xf,0x3,0x1,0x0,0x0,0x0,0x0,0x0,0x0,0x0,0x0,0x0,0x0,0x0,0xfc,0xfc,0x0,0x0,0x0,0x0,0x0,0x0,0xfc,0xfc,0x0,0x0,0xfc,0xfc,0xc,0x78,0xe0,0x80,0x0,0x0,0xfc,0xfc,0x0,0x0,0xfc,0xfc,0x0,0x0,0x0,0x0,0x0,0x0,0xfc,0xfc,0x4,0x4,0x4,0x8c,0xf8,0x70,0x0,0x0,0x0,0x0,0x0,0x0,0x0,0x0,0x0,0x0,0x0,0x1,0x3,0xf,0x1f,0xff,0xff,0xff,0xfd,0xff,0x0,0xff,
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
};

#endif
