FedeAdra25/despertadorInteligente/Archivos de uso Temporal/DHT22_Fede/STM32F103C6/main.h

#ifndef MAIN_H
#define MAIN_H


#define F_CPU 36000000UL
#include <stm32f103x6.h>
#include <stdlib.h>
#include <stdio.h>
#include <string.h>
#include "utils.h"
#include "usart.h"
#include <dht22.h>

#endif
