FedeAdra25/despertadorInteligente/Archivos de uso Temporal/RTC/STM32F103C6/main.h

#ifndef  MAIN_H
#define MAIN_H

#define F_CPU 72000000UL

#include <stm32f103x6.h>
#include <lcd.h>
#include <stdint.h>
#include <stdio.h>
#include <stdlib.h>
#include <utils.h>
#include "ds1307.h"


#endif
