FedeAdra25/despertadorInteligente/Archivos de uso Temporal/DHT22 with Display/TestingCubeMX_LED/Core/Src/main.c

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
/* Includes ------------------------------------------------------------------*/
#include "main.h"

/* USER CODE BEGIN Includes */
#include "i2c_drive.h"
#include "MY_DHT22.h"
#include <stdio.h>
#include "gp_drive.h"
#include "systick_time.h"
#include "SPI_Drive.h"
#include "n5110_drive.h"


/* USER CODE END Includes */

UART_HandleTypeDef huart1;

void SystemClock_Config(void);
static void MX_GPIO_Init(void);
static void MX_USART1_UART_Init(void);
/* USER CODE BEGIN 0 */
float Temperature, Humidity;

/* USER CODE END 0 */

/**
  * @brief  The application entry point.
  * @retval int
  */
int main(void)
{
  /* MCU Configuration--------------------------------------------------------*/

  /* Reset of all peripherals, Initializes the Flash interface and the Systick. */
  HAL_Init();

  /* Configure the system clock */
  SystemClock_Config();

  /* Initialize all configured peripherals */
  MX_GPIO_Init();
  MX_USART1_UART_Init();
	
  /* USER CODE BEGIN 2 */

	/* AUX VARIABLES */
	char buf[50];
	char onMsg[] = "ON\n\r";
	char offMsg[] = "OFF\n\r";
	int dayCounter = 0;
	
	/*I2C AUX VAR*/
	char data[2] = {0x01,0x02};
	
	unsigned char n5110_buffer[6][84];	//6 Rows 84 Columns
	

	
	/*Systick Init*/
	//systick_init();	//For some reason, this crashes everything 
	
	/*DHT22 Init*/
	DHT22_Init(GPIOB, GPIO_PIN_15);
	
	/* SPI 1 Init*/
	spi_init(1);
	
	/* N5110 Init */
	n5110_init(1);
	
	/* DISPLAY IMAGES*/
	/* INDEX 
			0 = NO-DAY-SELECTED
			1 = LUNES
			2 = MARTES
			3 = MIERCOLES
			4 = JUEVES
			5 = VIERNES
			6 = SABADO
			7 = DOMINGO
	*/
	ImgType display_pic = {.h = display_rows, .w = display_cols, .x = 0, .y = 0};
	display_pic.image[0] = display;
	display_pic.image[1] = display_lunes;
	display_pic.image[2] = display_martes;
	display_pic.image[3] = display_miercoles;
	display_pic.image[4] = display_jueves;
	display_pic.image[5] = display_viernes;
	display_pic.image[6] = display_sabado;
	display_pic.image[7] = display_domingo;
	
	/*Welcome Screen */
	ImgType welcome_pic = {.h = welcome_screen_rows, .w = welcome_screen_cols, .x = 0, .y = 0};
	welcome_pic.image[0] = welcome_screen;
	
	
	
	
	n5110_clear();
	n5110_clear_buffer(n5110_buffer);
	
	/* Welcome Screen 5 seconds delay */
	n5110_update_buffer(welcome_pic, 0, n5110_buffer);
	HAL_Delay(1000);
	n5110_print_buffer(n5110_buffer);
	HAL_Delay(5000);
	
	n5110_update_buffer(display_pic, 0, n5110_buffer);
	/* MEMO: Con el update str buffer podes agregar una string 
	si el fondo no tiene nada. 
	Asi que podemos poner la hora, abajo la temperatura y humedad por separado.
		Y despues hacer el Clear de todo junto y repetir*/

	
	
	
	
	//La lectura queda en bucle infinito. Solo puedo leeer el DHT22 una UNICA vez. Sad
	if (DHT22_GetTemp_Humidity(&Temperature,&Humidity) == 1 ){
	sprintf(buf, "T %.1f H %.1f%%", Temperature, Humidity);
	HAL_UART_Transmit(&huart1,(uint8_t *)buf,strlen(buf),HAL_MAX_DELAY);
	HAL_Delay(1000);
	}
	
	n5110_update_str_buffer(1,6,buf,n5110_buffer);
	n5110_update_str_buffer(3,20,"HH:MM:SS",n5110_buffer);
	
	n5110_print_buffer(n5110_buffer);
	
	
	

  /* USER CODE END 2 */

  /* Infinite loop */
  /* USER CODE BEGIN WHILE */
  while (1)
  {
		

		/*
		//Old Display Code
		n5110_print(0,0,buf,1);
		HAL_Delay(5000); //Delay of 5s because Simulator
		toggle_GP(PA,2);
		*/
		
		
		
		//DelayMs(50);
		HAL_Delay(1000);
		
			if (DHT22_GetTemp_Humidity(&Temperature,&Humidity) == 1 ){
	sprintf(buf, "T %.1f H %.1f%%", Temperature, Humidity);
	HAL_UART_Transmit(&huart1,(uint8_t *)buf,strlen(buf),HAL_MAX_DELAY);
	HAL_Delay(1000);
	}
		
		/*
		spi_tx(1,'H');
		spi_tx(1,'e');
		spi_tx(1,'l');
		spi_tx(1,'l');
		spi_tx(1,'o');
		*/
		
		/* spi_msg(1,"Hello Dude"); */
		
		
		
		/* Enciendo y apago el LED PC13 indefinidamente*/
		HAL_GPIO_WritePin(GPIOC,GPIO_PIN_13,GPIO_PIN_SET);
		HAL_UART_Transmit(&huart1,(uint8_t *)onMsg,strlen(onMsg),HAL_MAX_DELAY);
		HAL_Delay(1000);

		HAL_GPIO_WritePin(GPIOC,GPIO_PIN_13,GPIO_PIN_RESET);
		HAL_UART_Transmit(&huart1,(uint8_t *)offMsg,strlen(offMsg),HAL_MAX_DELAY);
		HAL_Delay(1000);


		
		
		
		

    /* USER CODE END WHILE */

    /* USER CODE BEGIN 3 */
  }
  /* USER CODE END 3 */
}

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
