FedeAdra25/despertadorInteligente/Archivos de uso Temporal/DHT22 with Display/TestingCubeMX_LED/TestingCubeMX_LED.ioc

Mcu.UserName=STM32F103C8Tx
PA10.Signal=USART1_RX
PA12.Signal=GPIO_Output
PA13.GPIO_Label=TANGO_LED
PA13.Signal=GPIO_Output
PA9.Signal=USART1_TX
PB15.Signal=GPIO_Output
PC13-TAMPER-RTC.GPIO_Label=LED2
PC13-TAMPER-RTC.Signal=GPIO_Output
