FedeAdra25/despertadorInteligente/Archivos de uso Temporal/DHT22 with Display/TestingCubeMX_LED/Core/Inc/main.h

#define LED2_Pin GPIO_PIN_13
#define LED2_GPIO_Port GPIOC
#define TANGO_LED_Pin GPIO_PIN_13
#define TANGO_LED_GPIO_Port GPIOA
