FedeAdra25/despertadorInteligente/Archivos de uso Temporal/DHT22 with Display/TestingCubeMX_LED/Drivers/glcd_128x64/glcd_font.h

/**
 * @file glcd_font.h
 * @author Embedded Laboratory
 * @date July 3, 2016
 * @brief This file contains fonts to be used with Glcd Library.
 * 
 */ 

#ifndef GLCD_FONT_H
#define	GLCD_FONT_H

#include "config.h"

#ifdef	__cplusplus
extern "C" {
#endif

const u8_t Terminal8x8[] = {
    0x00, 0x00, 0x00, 0x00, 0x00, 0x00, 0x00, 0x00,  // Code for char  
    0x00, 0x00, 0x06, 0x5F, 0x06, 0x00, 0x00, 0x00,  // Code for char !
    0x00, 0x07, 0x03, 0x00, 0x07, 0x03, 0x00, 0x00,  // Code for char "
    0x00, 0x24, 0x7E, 0x24, 0x7E, 0x24, 0x00, 0x00,  // Code for char #
    0x00, 0x24, 0x2B, 0x6A, 0x12, 0x00, 0x00, 0x00,  // Code for char $
    0x00, 0x63, 0x13, 0x08, 0x64, 0x63, 0x00, 0x00,  // Code for char %
    0x00, 0x36, 0x49, 0x56, 0x20, 0x50, 0x00, 0x00,  // Code for char &
    0x00, 0x00, 0x07, 0x03, 0x00, 0x00, 0x00, 0x00,  // Code for char '
    0x00, 0x00, 0x3E, 0x41, 0x00, 0x00, 0x00, 0x00,  // Code for char (
    0x00, 0x00, 0x41, 0x3E, 0x00, 0x00, 0x00, 0x00,  // Code for char )
    0x00, 0x08, 0x3E, 0x1C, 0x3E, 0x08, 0x00, 0x00,  // Code for char *
    0x00, 0x08, 0x08, 0x3E, 0x08, 0x08, 0x00, 0x00,  // Code for char +
    0x00, 0x00, 0xE0, 0x60, 0x00, 0x00, 0x00, 0x00,  // Code for char ,
    0x00, 0x08, 0x08, 0x08, 0x08, 0x08, 0x00, 0x00,  // Code for char -
    0x00, 0x00, 0x60, 0x60, 0x00, 0x00, 0x00, 0x00,  // Code for char .
    0x00, 0x20, 0x10, 0x08, 0x04, 0x02, 0x00, 0x00,  // Code for char /
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
        0x00, 0x81, 0x77, 0x08, 0x00, 0x00, 0x00, 0x00,  // Code for char }
        0x18, 0x08, 0x10, 0x18, 0x00, 0x00, 0x00, 0x00,  // Code for char ~
        0x1F, 0x1F, 0x00, 0x00, 0x00, 0x00, 0x00, 0x00   // Code for char 
        };


#ifdef	__cplusplus
}
#endif

#endif	/* GLCD_FONT_H */
