FedeAdra25/despertadorInteligente/Archivos de uso Temporal/DHT22 with Display/TestingCubeMX_LED/Core/Src/systick_time.c

#include "stm32f10x.h" 
#include "systick_time.h"

void systick_init(void)
{
	SysTick->CTRL = 0;
	SysTick->LOAD = 0x00FFFFFF;
	SysTick->VAL = 0;
	SysTick->CTRL |= 5;
}

void DelayMillis(void)
{
	SysTick->LOAD = 0x11940;
	SysTick->VAL = 0;
	while((SysTick->CTRL & 0x00010000) == 0);
}

void DelayMs(unsigned long t)
{
	for(;t>0;t--)
		{
			DelayMillis();
		}
}

void systick_int_start(void)
{
	__disable_irq();
	SysTick->CTRL = 0;
	SysTick->LOAD = 720000;
	SysTick->VAL = 0;
	SysTick->CTRL |= 7;
	__enable_irq();
}

void systick_int(unsigned short uart_1_mgr[],unsigned short uart_2_mgr[],unsigned short uart_3_mgr[])
{
	if(uart_1_mgr[0]!=0)
	{
	 if(uart_1_mgr[6] == 0)
	 {
		uart_1_mgr[0] = 0;
		uart_1_mgr[1] = 1;
		uart_1_mgr[5] = 0;
		systick_init();
	 }
	 else
		{
		uart_1_mgr[6]--;
	 }
	}
	else if(uart_2_mgr[0]!=0)
	{
	 if(uart_2_mgr[6] == 0)
	 {
		uart_2_mgr[0] = 0;
		uart_2_mgr[1] = 1;
		uart_2_mgr[5] = 0;
		systick_init();
	 }
	 else
		{
		uart_2_mgr[6]--;
	 }
	}
	else if(uart_3_mgr[0]!=0)
	{
	 if(uart_3_mgr[6] == 0)
	 {
		uart_3_mgr[0] = 0;
		uart_3_mgr[1] = 1;
		uart_3_mgr[5] = 0;
		systick_init();
	 }
	 else
		{
		uart_3_mgr[6]--;
	 }
	}
}
