FedeAdra25/despertadorInteligente/(commit log)

2022-01-05 Folders for schematic and firmware
2022-01-18 DHT22 Cuestionablemente funcional
    [LED + DHT11 with CubeMX.pdsprj]
2022-01-18 Readme para entender como hacer andar el DHT22
2022-01-22 Added Display (with one example with DHT22)
    [LED + DHT11 with CubeMX.pdsprj]
2022-01-22 Muchas funciones para el Display. Ahora si es Grafico!
2022-01-23 Display con Ejemplo de TEMP/HUMEDAD + HORA + DIA
    [LED + DHT11 with CubeMX.pdsprj]
2022-01-23 Agregue los archivos Auxiliares de Python para la generacion de Archivos BMP
2022-01-23 Agregue una pantalla de Bienvenida con el logo de la UNLP y luego salta al template de T/H HHMMSS
2022-01-24 Codigo con el DHT en el While(1) para testear
    [LED + DHT11 with CubeMX.pdsprj]
2022-01-25 Agregue la version Proteus del SPI y Display. La Struct de ImgType no funciona
    [SPI Display.pdsprj]
2022-01-26 UART + DHT22 en Proteus. Falta chequear los timings
    [UART + DHT22.pdsprj]
2022-01-29 RTC DONE
    [LED + DHT11 with CubeMX.pdsprj, rtc.pdsprj]
2022-01-29 Cherry pick DHT files from master so they don't change
    [LED + DHT11 with CubeMX.pdsprj]
2022-01-31 Display working
    [SPI Display.pdsprj]
2022-02-01 DESPERTADOR INTELIGENTE
    [Despertador_Inteligente.pdsprj]
2022-02-02 Added folder with Bluepill for Schematic/PCB
2022-02-02 esquematico listo (creo)
    [schematicDespertadorInteligente.pdsprj]
2022-02-03 PCB Template
    [Despertador_Inteligente.pdsprj, schematicDespertadorInteligente.pdsprj]
2022-02-03 MEF drawio and .... Changes In firmware?
    [Despertador_Inteligente.pdsprj]
2022-02-07 Firmware avanzado, estados de la mef codeados
    [Despertador_Inteligente.pdsprj]
2022-02-07 MEF funcionando. Faltan animaciones, modularizar mejor y SEOS
    [Despertador_Inteligente.pdsprj]
2022-02-08 Animation done
    [Despertador_Inteligente.pdsprj]
2022-02-11 Buttons and buzzer with different ports
    [Despertador_Inteligente.pdsprj]
2022-02-11 Firmware schematic changed
    [Despertador_Inteligente.pdsprj]
2022-02-12 Push todo funcional
    [Despertador_Inteligente.pdsprj]
2022-02-13 RTC e I2C cambiados
    [Despertador_Inteligente.pdsprj]
2022-02-13 More code changes
    [Despertador_Inteligente.pdsprj]
2022-02-15 Modificacion del arbol para orden general
    [LED + DHT11 with CubeMX.pdsprj, LED + DHT11.pdsprj, SPI Display.pdsprj, UART + DHT22.pdsprj, rtc.pdsprj]
2022-02-15 Schematic + PCB Actualizados
    [schematicDespertadorInteligente.pdsprj, schematicDespertadorInteligente_v2.pdsprj]
