FedeAdra25/despertadorInteligente/(notices)

Notices in the files:
Archivos de uso Temporal/DHT22 with Display/TestingCubeMX_LED/Core/Src/main.c:
Copyright (c) 2022 STMicroelectronics.
All rights reserved.
This software is licensed under terms that can be found in the LICENSE file
